CoderCallender/DSP_Projects/Basic_DSP_V0_1/Basic_DSP_V0_1.kicad_pcb

## KiCad design Basic_DSP_V0_1/Basic_DSP_V0_1.kicad_pcb (2024-11-25)

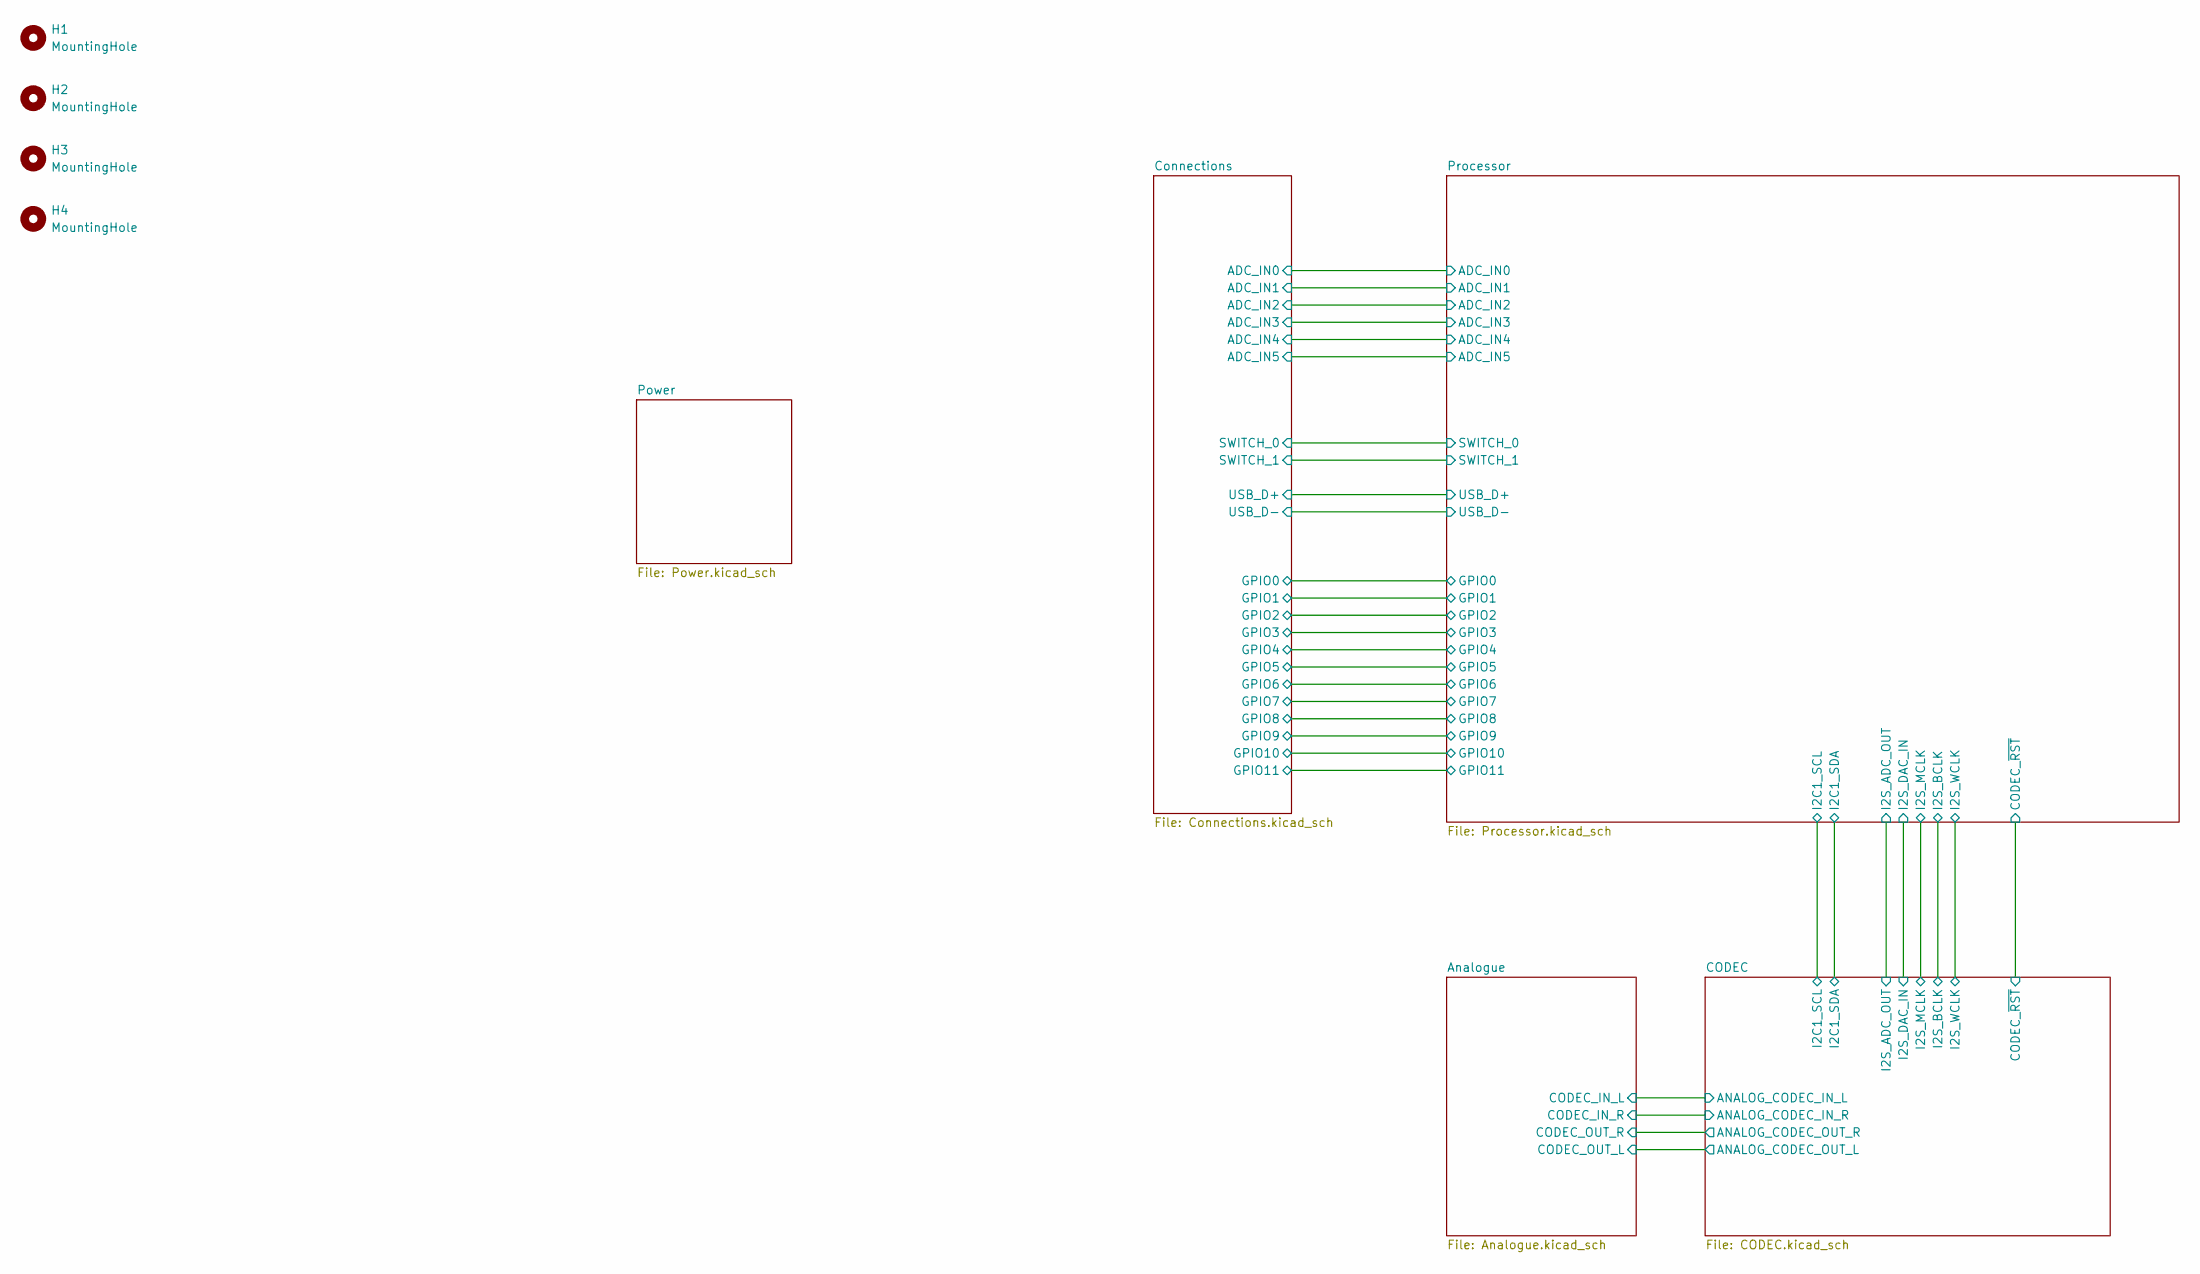
[picture p1: schematic Basic_DSP_V0_1.kicad_sch]

Parts:
H1, H2, H3, H4: MountingHole; MountingHole_3.2mm_M3_ISO7380_Pad

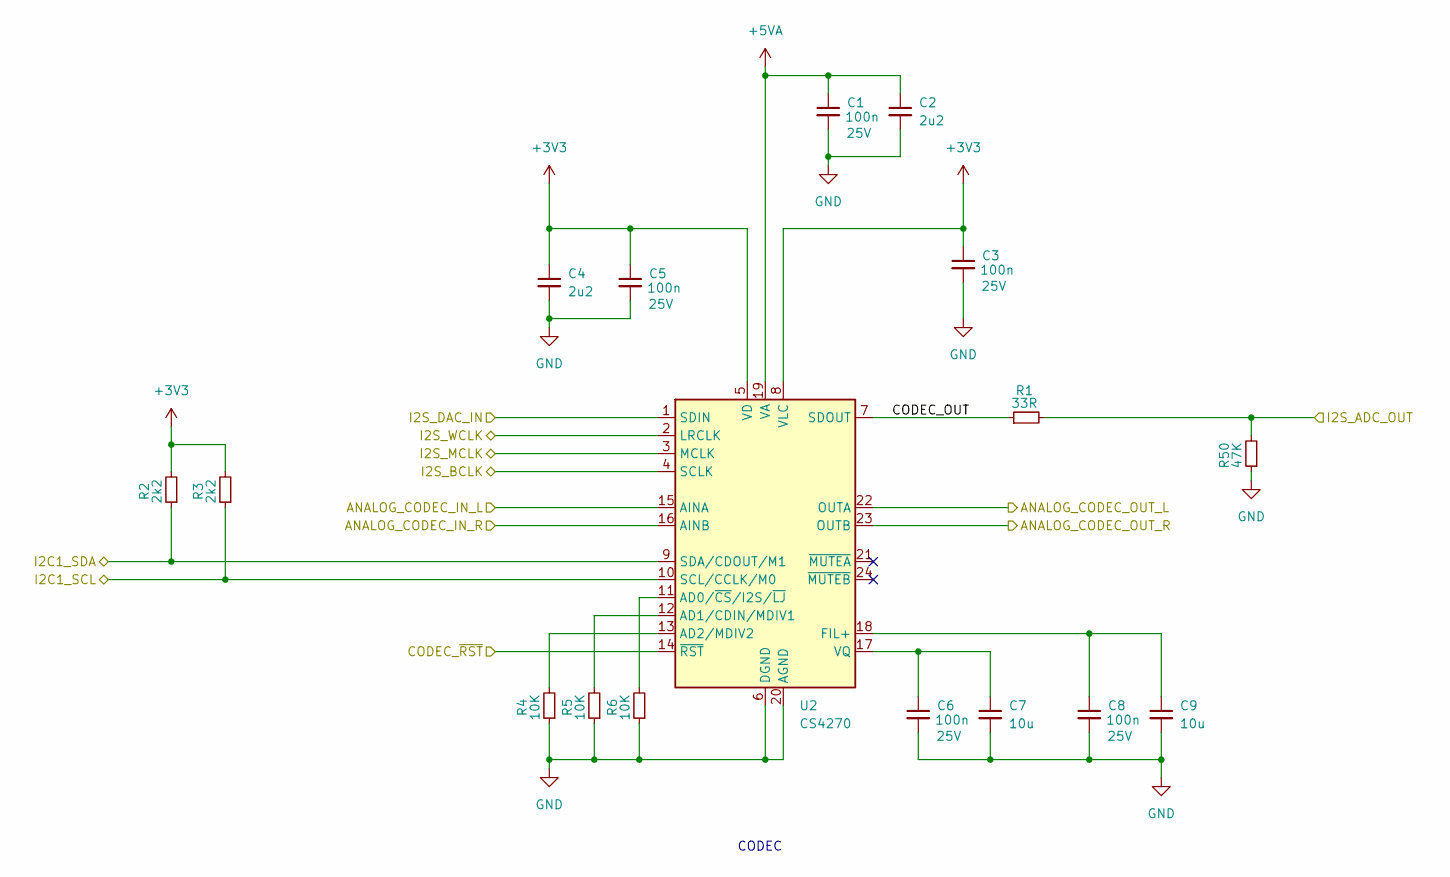
[picture p2: schematic CODEC.kicad_sch]

Parts:
C1, C3, C5, C6, C8: 100n; C_0603_1608Metric_Pad1.08x0.95mm_HandSolder; Voltage 25V; MPN 0603B104M250NT
C2, C4: 2u2; C_0603_1608Metric_Pad1.08x0.95mm_HandSolder; Voltage 25V; MPN 0603B225K250NT
C7, C9: 10u; C_0603_1608Metric_Pad1.08x0.95mm_HandSolder; Voltage 25V; MPN CL10A106MA8NRNC
R1: 33R; R_0603_1608Metric_Pad0.98x0.95mm_HandSolder; MPN WR06X33R0FTL
R2, R3: 2k2; R_0603_1608Metric_Pad0.98x0.95mm_HandSolder; MPN 0603WAF2201T5E
R4, R5, R6: 10K; R_0603_1608Metric_Pad0.98x0.95mm_HandSolder; MPN 0603WAF1002T5E
R50: 47K; R_0603_1608Metric_Pad0.98x0.95mm_HandSolder; MPN RC0603FR-0747KL
U2: CS4270; TSSOP-24_4.4x7.8mm_P0.65mm; MPN CS4270-CZZR

Connections:
+3V3: C3.1, C4.1, C5.1, R2.2, R3.2, U2.5 (VD), U2.8 (VLC); also elsewhere on the board
+5VA: C1.1, C2.1, U2.19 (VA); also elsewhere on the board
/Analogue/CODEC_IN_L: U2.15 (AINA); also elsewhere on the board
/Analogue/CODEC_IN_R: U2.16 (AINB); also elsewhere on the board
/Analogue/CODEC_OUT_L: U2.22 (OUTA); also elsewhere on the board
/Analogue/CODEC_OUT_R: U2.23 (OUTB); also elsewhere on the board
/CODEC/CODEC_OUT: R1.1, U2.7 (SDOUT)
/CODEC/CODEC_~RST: U2.14 (~RST); also elsewhere on the board
/CODEC/I2C1_SCL: R3.1, U2.10 (SCL/CCLK/M0); also elsewhere on the board
/CODEC/I2C1_SDA: R2.1, U2.9 (SDA/CDOUT/M1); also elsewhere on the board
/CODEC/I2S_ADC_OUT: R1.2, R50.2; also elsewhere on the board
/CODEC/I2S_BCLK: U2.4 (SCLK); also elsewhere on the board
/CODEC/I2S_DAC_IN: U2.1 (SDIN); also elsewhere on the board
/CODEC/I2S_MCLK: U2.3 (MCLK); also elsewhere on the board
/CODEC/I2S_WCLK: U2.2 (LRCLK); also elsewhere on the board
GND: C1.2, C2.2, C3.2, C4.2, C5.2, C6.2, C7.2, C8.2, C9.2, R4.1, R5.1, R6.1, R50.1, U2.6 (DGND), U2.20 (AGND); also elsewhere on the board
unnamed: R6.2, U2.11 (AD0/~CS/I2S/~LJ)
unnamed: R5.2, U2.12 (AD1/CDIN/MDIV1)
unnamed: R4.2, U2.13 (AD2/MDIV2)
unnamed: C8.1, C9.1, U2.18 (FIL+)
unnamed: C6.1, C7.1, U2.17 (VQ)

Notes on the sheet:
CODEC

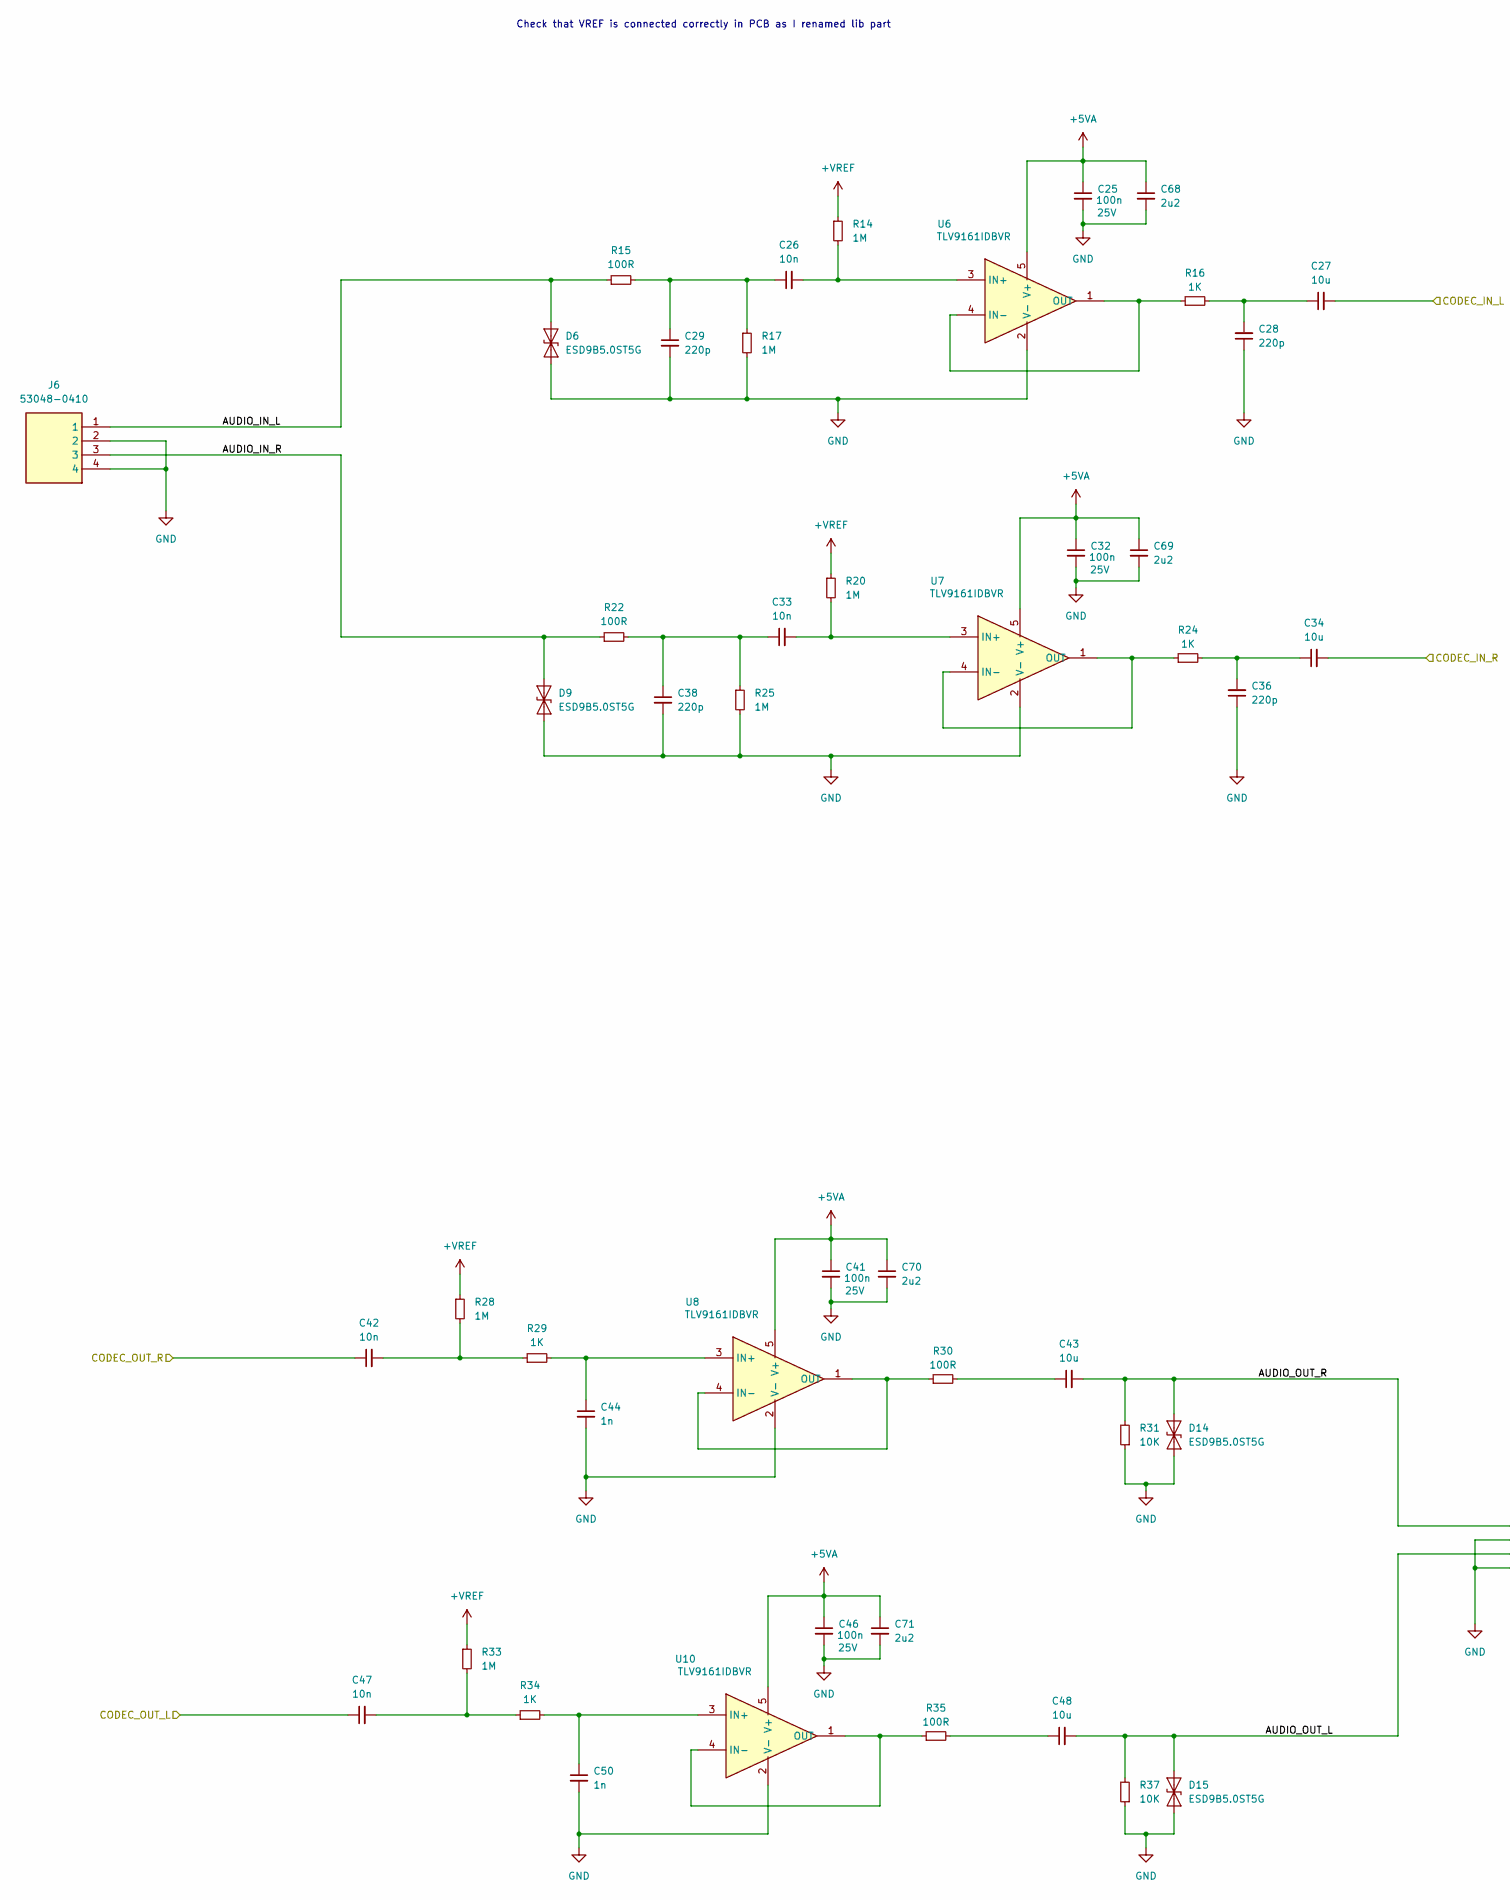
[picture p3: schematic Analogue.kicad_sch, part in row 1, column 1]

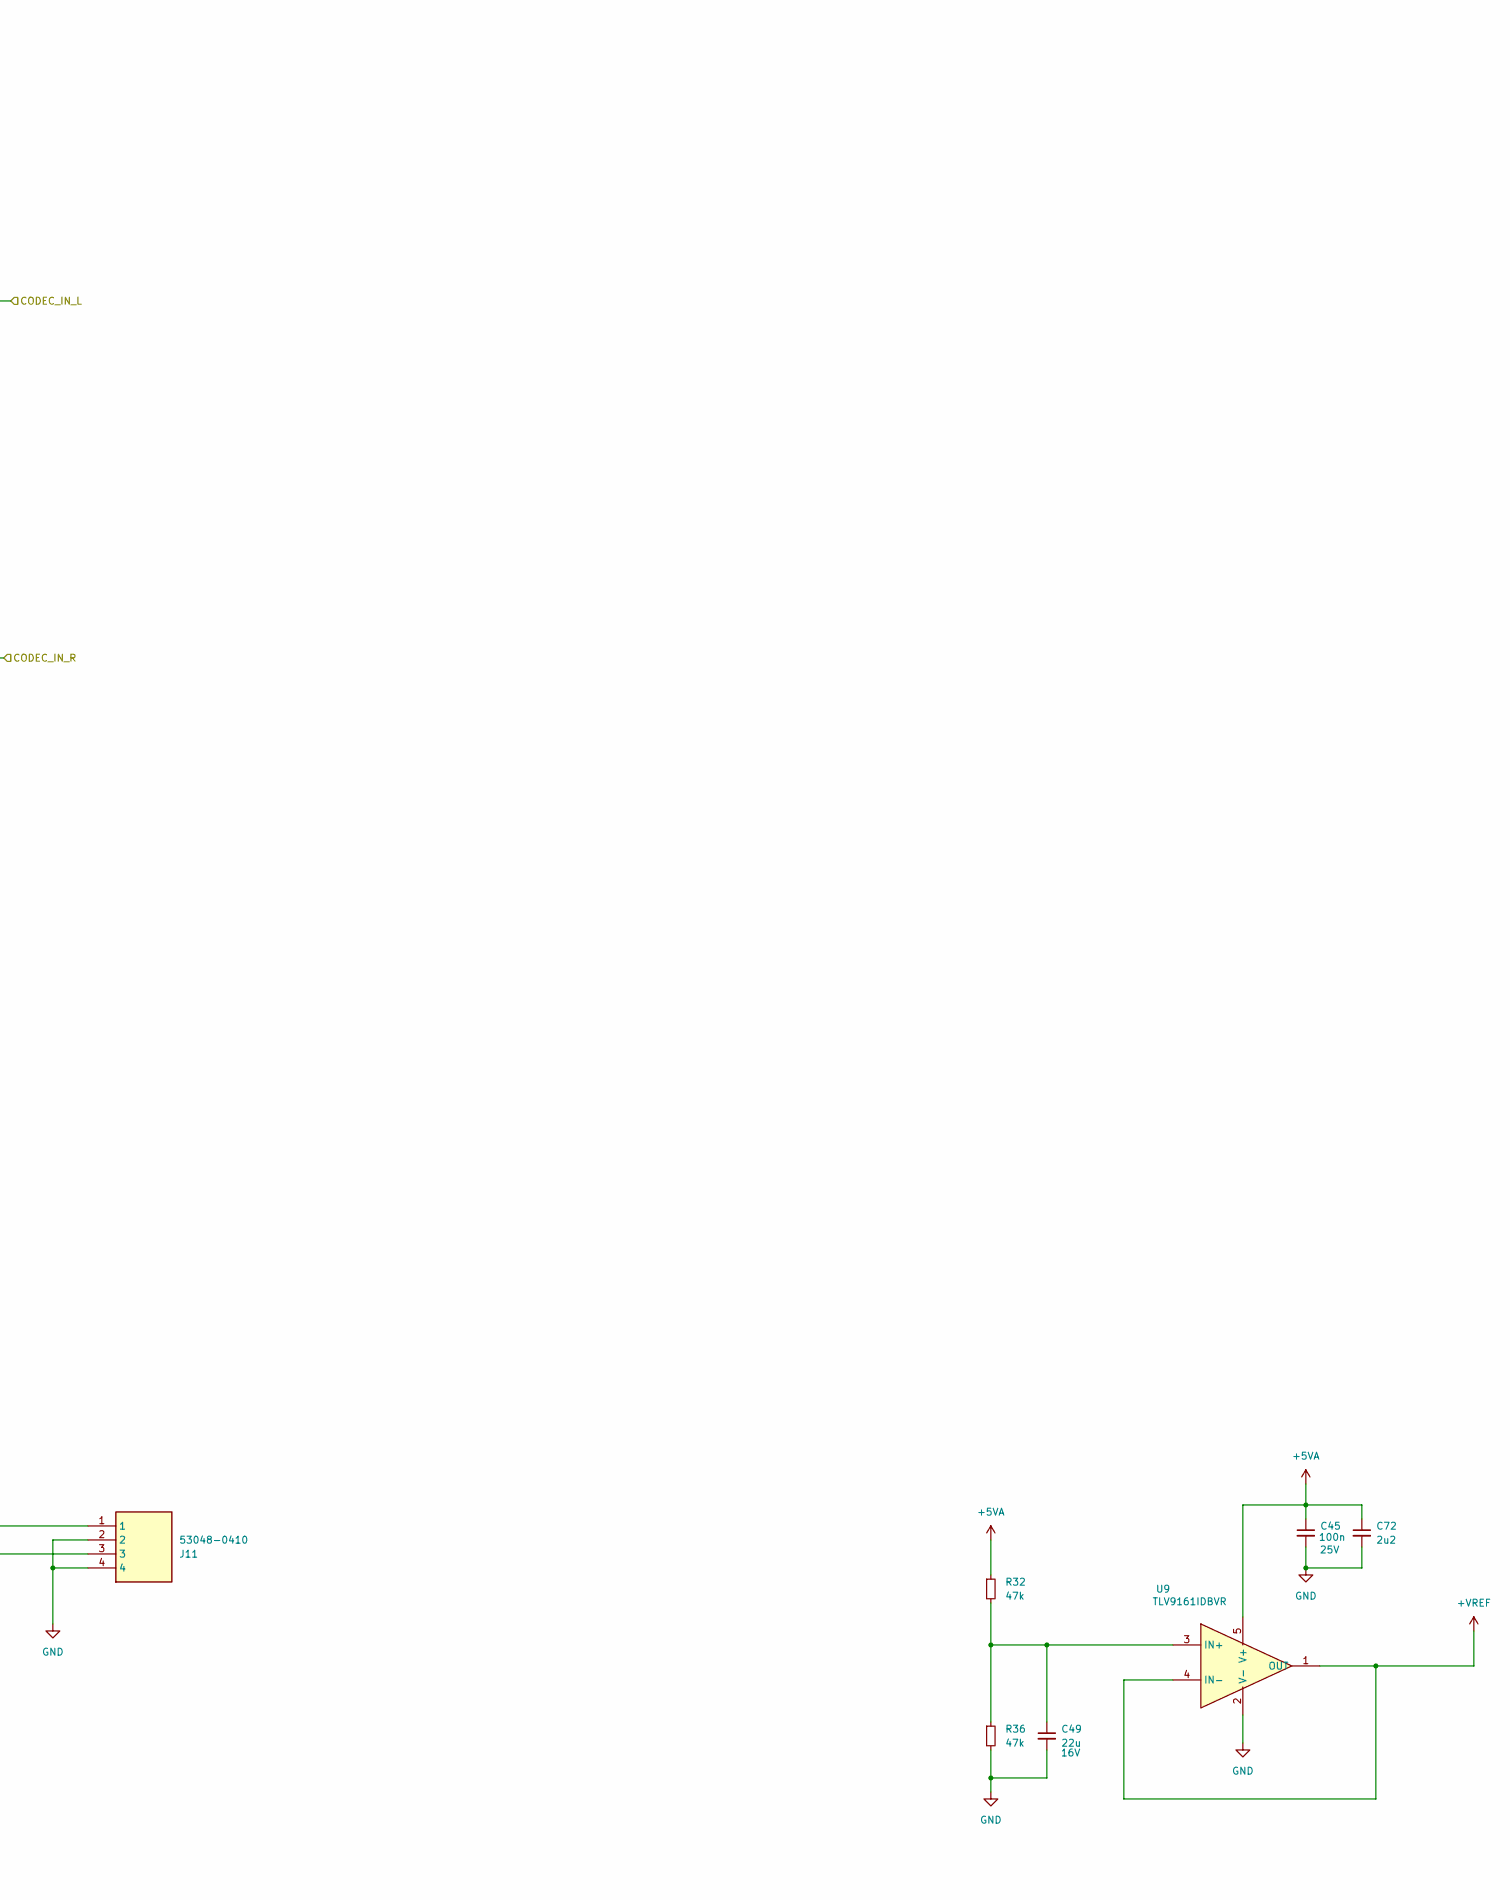
[picture p4: schematic Analogue.kicad_sch, part in row 1, column 2]

Parts:
C25, C32, C41, C45, C46: 100n; C_0603_1608Metric_Pad1.08x0.95mm_HandSolder; Voltage 25V; MPN 0603B104M250NT
C26, C33, C42, C47: 10n; C_0603_1608Metric_Pad1.08x0.95mm_HandSolder; MPN CGA3E2X8R2A103KT0Y0H
C27, C34, C43, C48: 10u; C_0603_1608Metric_Pad1.08x0.95mm_HandSolder; Voltage 16V; MPN CL10A106MA8NRNC
C28, C29, C36, C38: 220p; C_0603_1608Metric_Pad1.08x0.95mm_HandSolder; MPN 0603N221J500CT
C44, C50: 1n; C_0603_1608Metric_Pad1.08x0.95mm_HandSolder; MPN GCJ188R71H102KA01D
C49: 22u; C_0603_1608Metric_Pad1.08x0.95mm_HandSolder; Voltage 16V; MPN CGA0603X5R226M160JT
C68, C69, C70, C71, C72: 2u2; C_0603_1608Metric_Pad1.08x0.95mm_HandSolder; Voltage 25V; MPN 0603B225K250NT
D6, D9, D14, D15: ESD9B5.0ST5G; D_SOD-923; MPN ESD9B5.0ST5G
J6, J11: 53048-0410; 530480410; Mouser Part Number 538-53048-0410
R14, R17, R20, R25, R28, R33: 1M; R_0603_1608Metric_Pad0.98x0.95mm_HandSolder; MPN 0603WAF1004T5E
R15, R22, R30, R35: 100R; R_0603_1608Metric_Pad0.98x0.95mm_HandSolder; MPN RC0603FR-07100RL
R16, R24, R29, R34: 1K; R_0603_1608Metric_Pad0.98x0.95mm_HandSolder; MPN 0603WAJ0102T5E
R31, R37: 10K; R_0603_1608Metric_Pad0.98x0.95mm_HandSolder; MPN 0603WAF1002T5E
R32, R36: 47k; R_0603_1608Metric_Pad0.98x0.95mm_HandSolder; MPN RC0603FR-0747KL
U6, U7, U8, U9, U10: TLV9161IDBVR; SOT95P280X145-5N; Mouser Part Number 595-TLV9161IDBVR

Connections:
+5VA: C25.1, C32.1, C41.1, C45.1, C46.1, C68.1, C69.1, C70.1, C71.1, C72.1, R32.1, U6.5 (V+), U7.5 (V+), U8.5 (V+), U9.5 (V+), U10.5 (V+); also elsewhere on the board
+VREF: R14.1, R20.1, R28.1, R33.1, U9.1 (OUT), U9.4 (IN-)
/Analogue/AUDIO_IN_L: D6.2 (A2), J6.1, R15.1
/Analogue/AUDIO_IN_R: D9.2 (A2), J6.3, R22.1
/Analogue/AUDIO_OUT_L: C48.2, D15.2 (A2), J11.3, R37.2
/Analogue/AUDIO_OUT_R: C43.2, D14.2 (A2), J11.1, R31.2
/Analogue/CODEC_IN_L: C27.2; also elsewhere on the board
/Analogue/CODEC_IN_R: C34.2; also elsewhere on the board
/Analogue/CODEC_OUT_L: C47.1; also elsewhere on the board
/Analogue/CODEC_OUT_R: C42.1; also elsewhere on the board
GND: C25.2, C28.1, C29.2, C32.2, C36.1, C38.2, C41.2, C44.2, C45.2, C46.2, C49.2, C50.2, C68.2, C69.2, C70.2, C71.2, C72.2, D6.1 (A1), D9.1 (A1), D14.1 (A1), D15.1 (A1), J6.2, J6.4, J11.2, J11.4, R17.2, R25.2, R31.1, R36.2, R37.1, U6.2 (V-), U7.2 (V-), U8.2 (V-), U9.2 (V-), U10.2 (V-); also elsewhere on the board
unnamed: C26.1, C29.1, R15.2, R17.1
unnamed: C27.1, C28.2, R16.2
unnamed: C33.1, C38.1, R22.2, R25.1
unnamed: C34.1, C36.2, R24.2
unnamed: C42.2, R28.2, R29.1
unnamed: C43.1, R30.2
unnamed: C47.2, R33.2, R34.1
unnamed: C48.1, R35.2
unnamed: C26.2, R14.2, U6.3 (IN+)
unnamed: R16.1, U6.1 (OUT), U6.4 (IN-)
unnamed: C33.2, R20.2, U7.3 (IN+)
unnamed: R24.1, U7.1 (OUT), U7.4 (IN-)
unnamed: C44.1, R29.2, U8.3 (IN+)
unnamed: R30.1, U8.1 (OUT), U8.4 (IN-)
unnamed: C49.1, R32.2, R36.1, U9.3 (IN+)
unnamed: C50.1, R34.2, U10.3 (IN+)
unnamed: R35.1, U10.1 (OUT), U10.4 (IN-)

Notes on the sheet:
Check that VREF is connected correctly in PCB as I renamed lib part

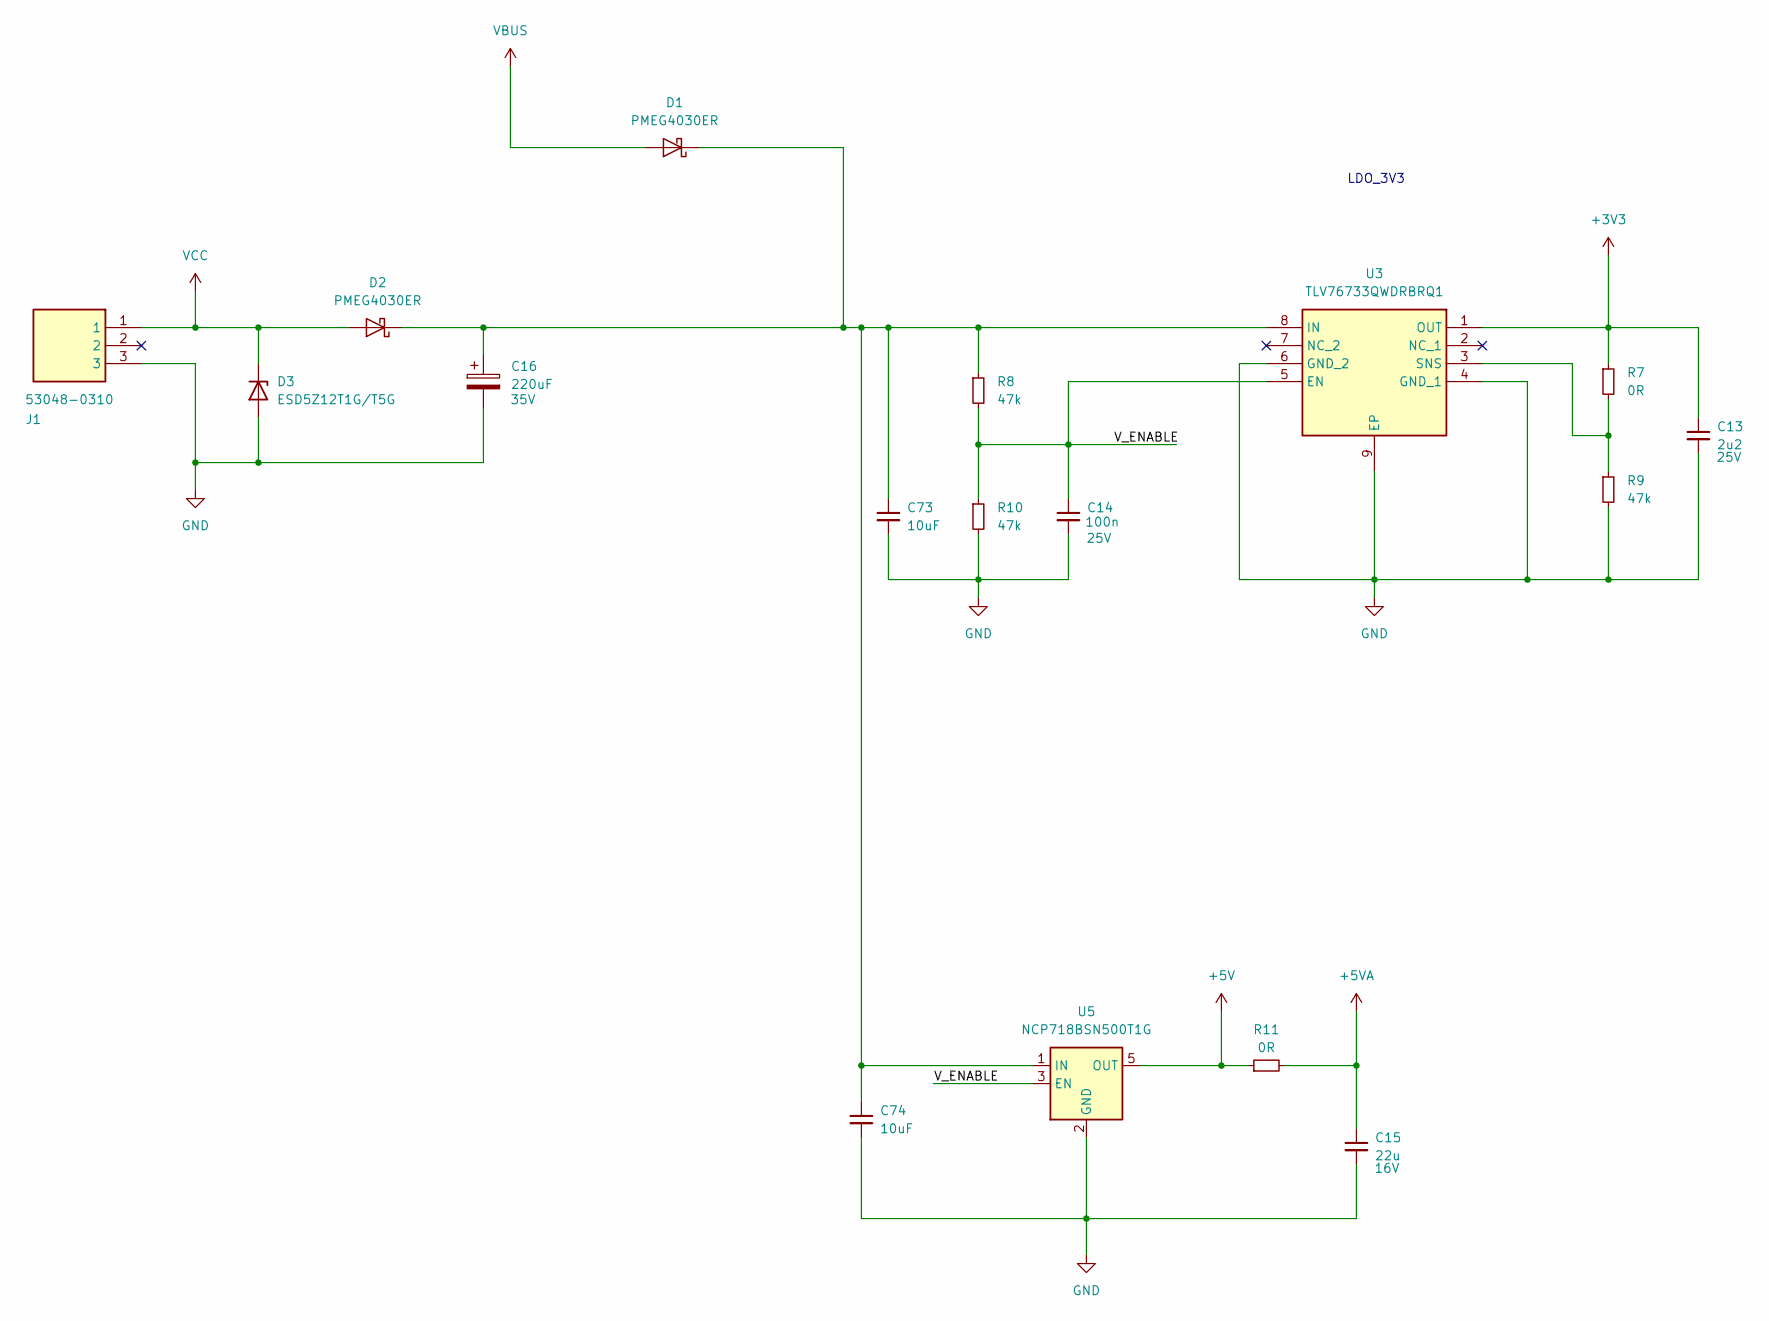
[picture p5: schematic Power.kicad_sch]

Parts:
C13: 2u2; C_0603_1608Metric_Pad1.08x0.95mm_HandSolder; Voltage 25V; MPN 0603B225K250NT
C14: 100n; C_0603_1608Metric_Pad1.08x0.95mm_HandSolder; Voltage 25V; MPN 0603B104M250NT
C15: 22u; C_0603_1608Metric_Pad1.08x0.95mm_HandSolder; Voltage 16V; MPN CGA0603X5R226M160JT
C16: 220uF; CP_Elec_8x10.5; Voltage 35V; MPN CK1V221M-CRF10
C73, C74: 10uF; C_0603_1608Metric; MPN CL10A106MA8NRNC
D1, D2: PMEG4030ER; Nexperia_CFP3_SOD-123W; MPN PMEG4030ER
D3: ESD5Z12T1G/T5G; D_SOD-523; Voltage 12V; MPN ESD5Z12T1G
J1: 53048-0310; SHDRRA3W35P0X125_1X3_550X550X350P; Mouser Part Number 538-53048-0310
R7: 0R; R_0603_1608Metric_Pad0.98x0.95mm_HandSolder; MPN 0603WAF0000T5E
R8, R9, R10: 47k; R_0603_1608Metric_Pad0.98x0.95mm_HandSolder; MPN RC0603FR-0747KL
R11: 0R; R_0603_1608Metric_Pad0.98x0.95mm_HandSolder; MPN 0603WAF100JT5E
U3: TLV76733QWDRBRQ1; SON65P300X300X100-9N-D; Mouser Part Number 595-TLV76733QWDRBRQ1
U5: NCP718BSN500T1G; SOT-23-5; MPN NCP718BSN500T1G

Connections:
+3V3: C13.1, R7.1, U3.1 (OUT); also elsewhere on the board
+5V: R11.1, U5.5 (OUT); also elsewhere on the board
+5VA: C15.1, R11.2; also elsewhere on the board
/Power/V_ENABLE: C14.1, R8.2, R10.1, U3.5 (EN), U5.3 (EN)
GND: C13.2, C14.2, C15.2, C16.2, C73.2, C74.2, D3.2 (A), J1.3, R9.2, R10.2, U3.4 (GND_1), U3.6 (GND_2), U3.9 (EP), U5.2 (GND); also elsewhere on the board
unnamed: C16.1, C73.1, C74.1, D1.1 (K), D2.1 (K), R8.1, U3.8 (IN), U5.1 (IN)
unnamed: R7.2, R9.1, U3.3 (SNS)
VBUS: D1.2 (A); also elsewhere on the board
VCC: D2.2 (A), D3.1 (K), J1.1

Notes on the sheet:
LDO_3V3

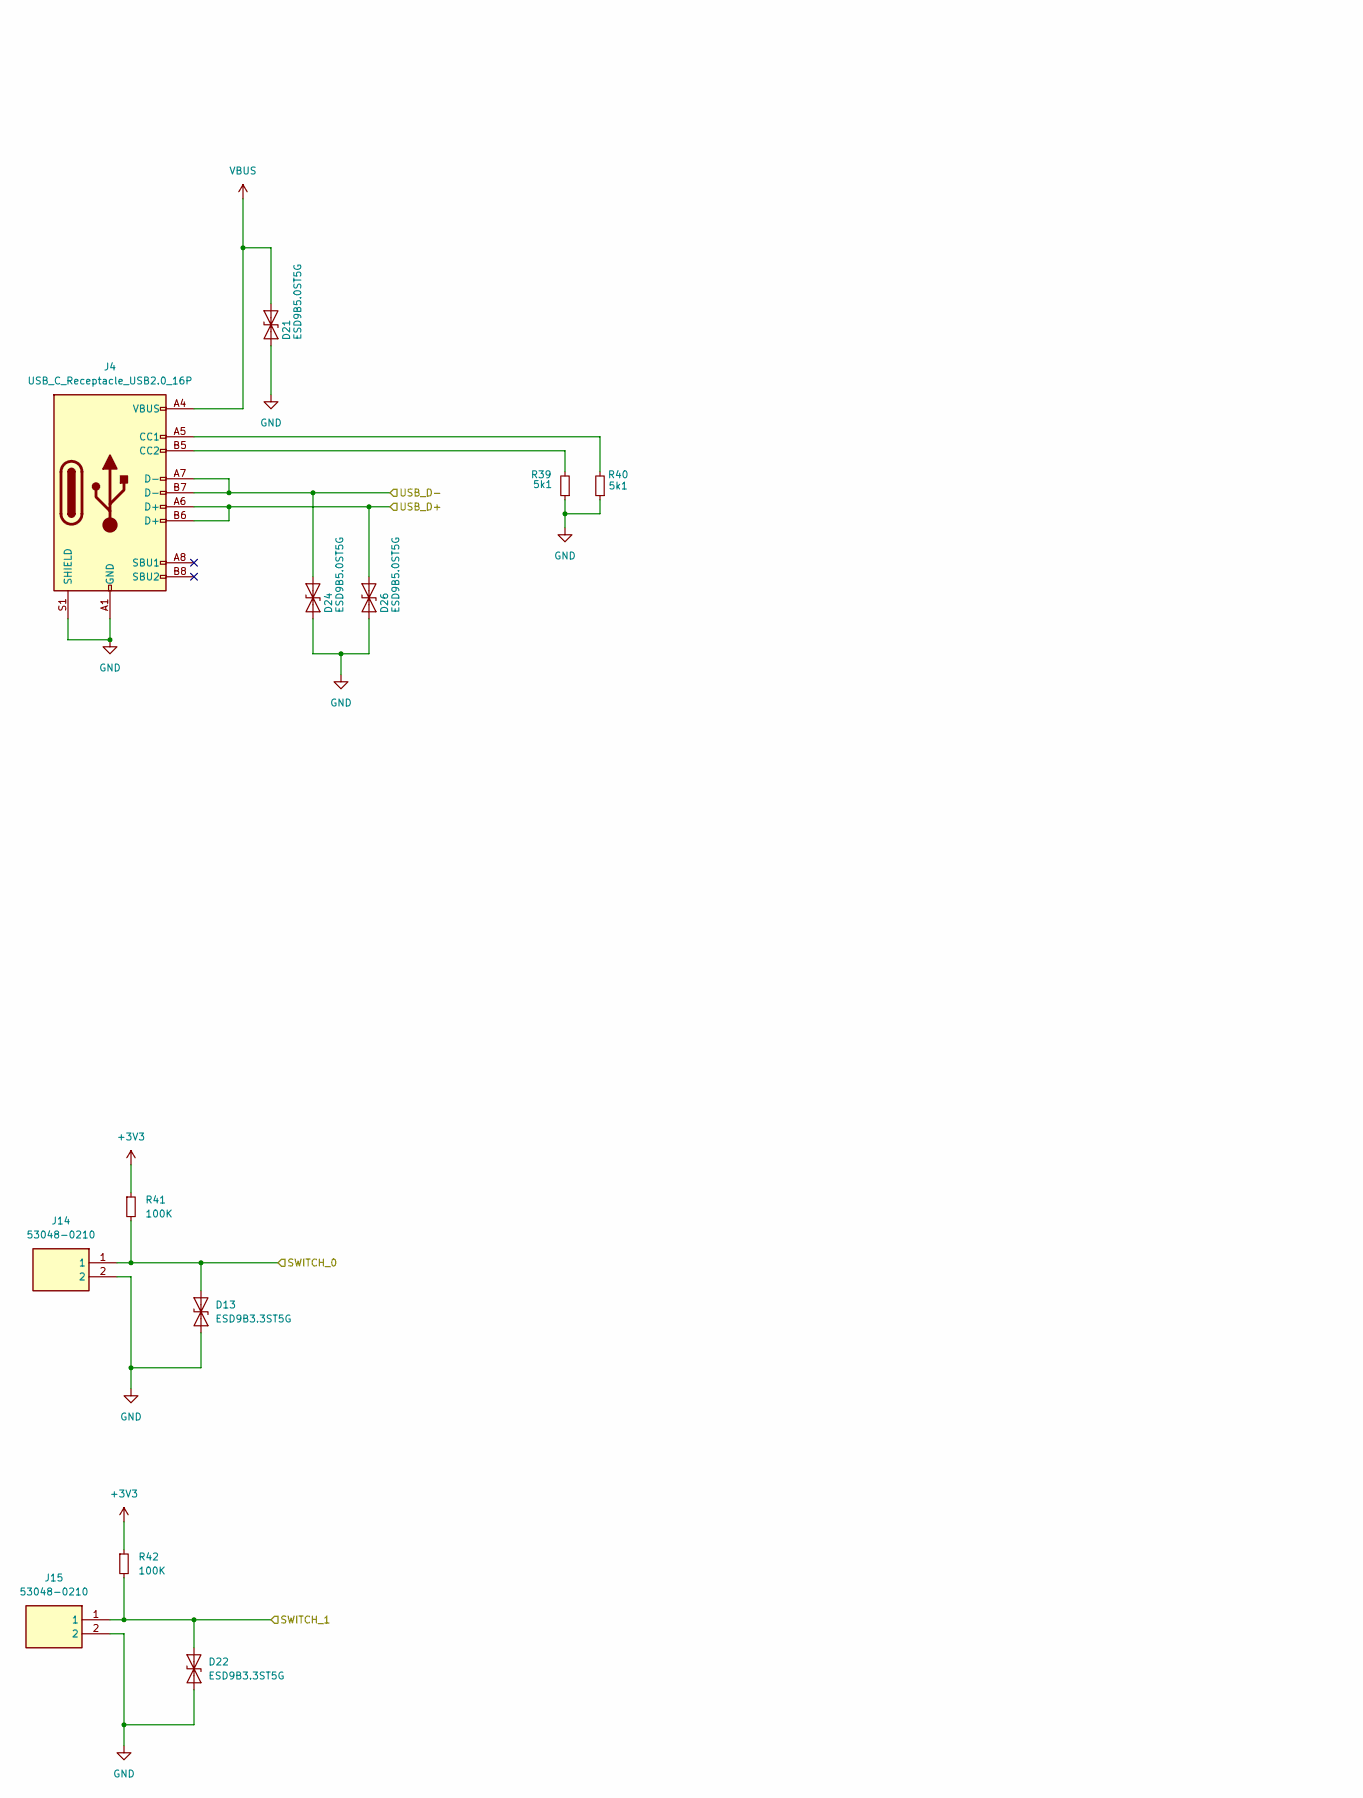
[picture p6: schematic Connections.kicad_sch, part in row 1, column 1]

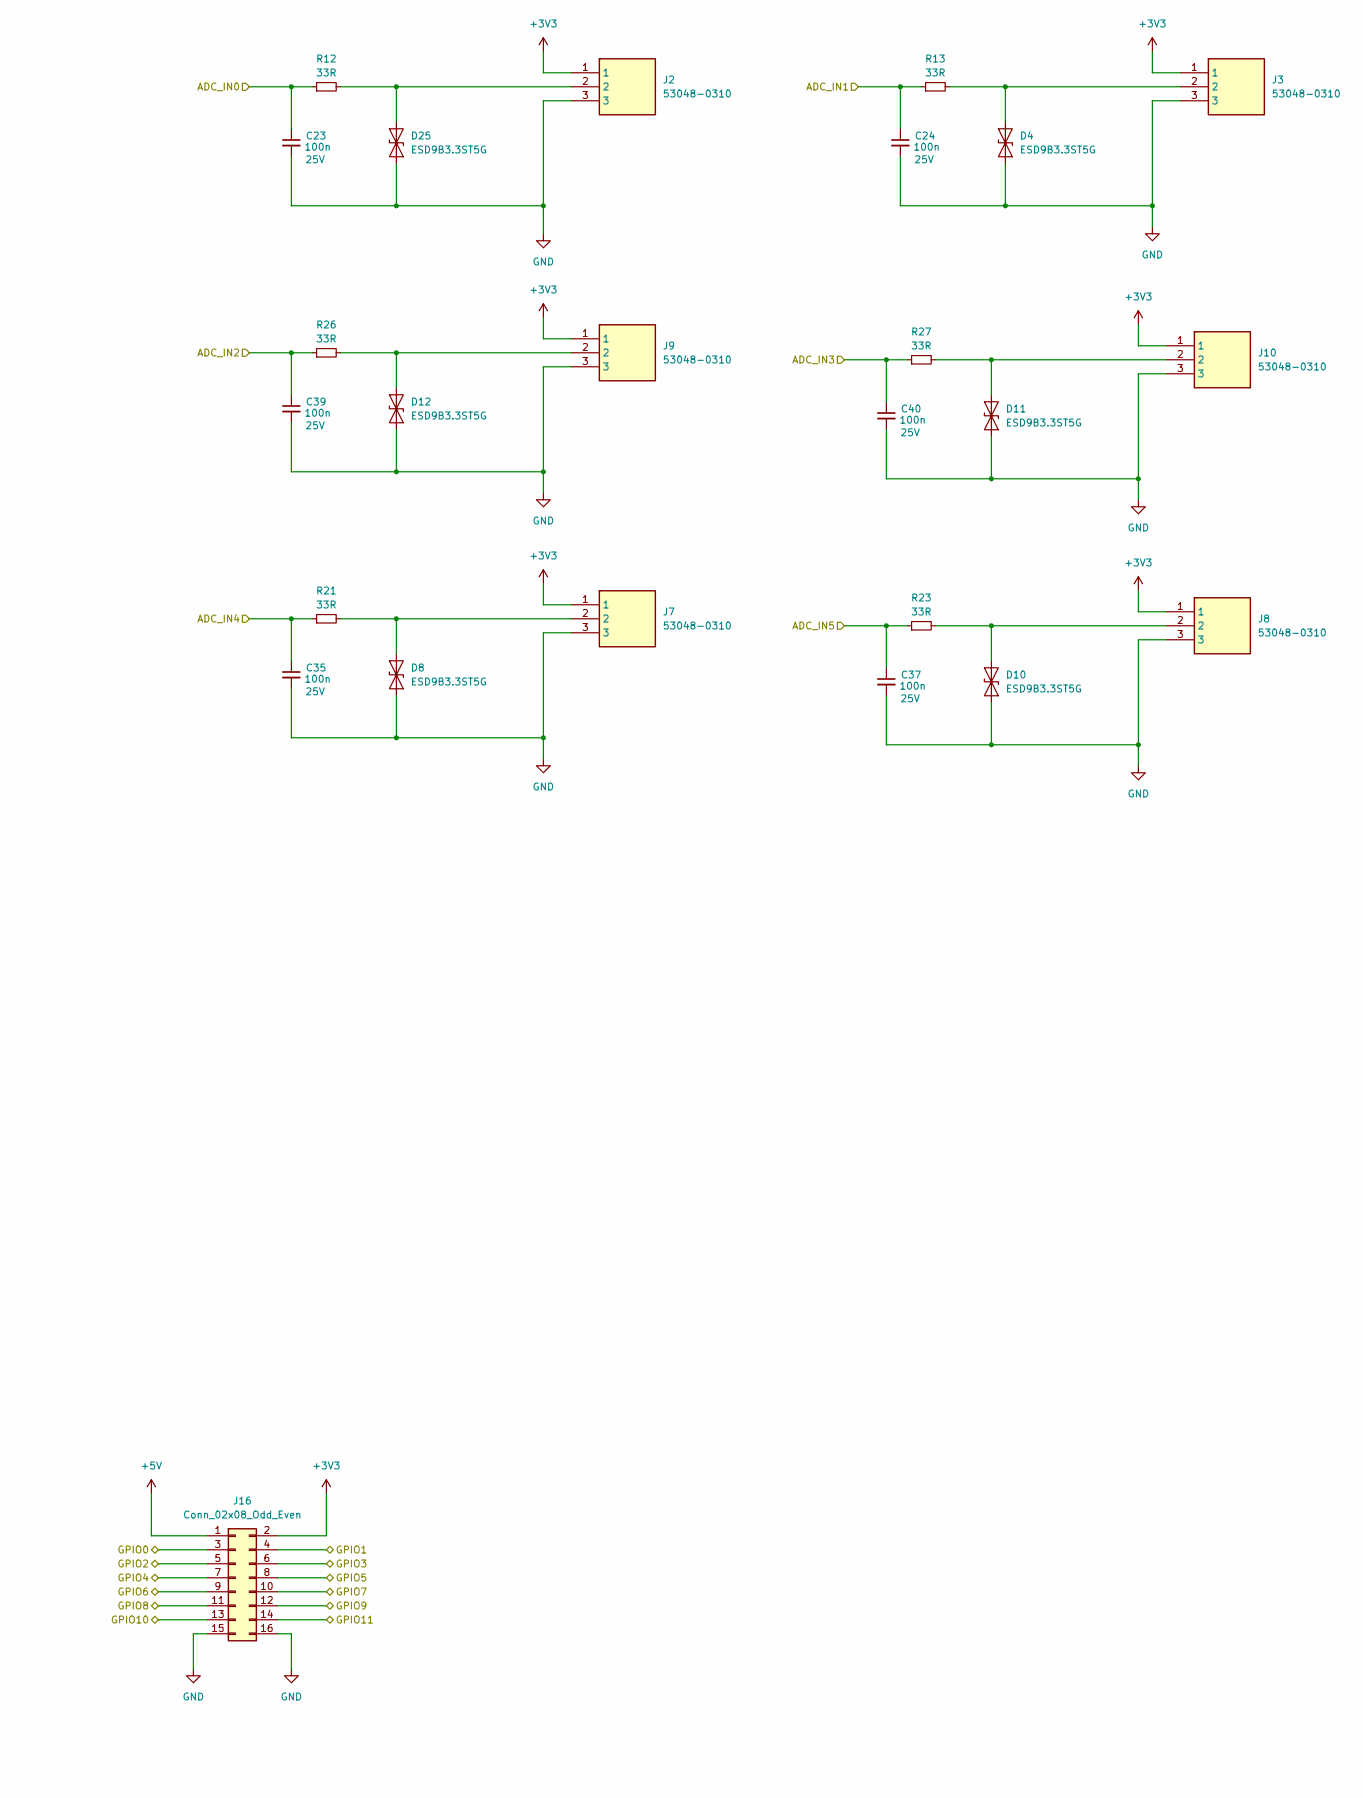
[picture p7: schematic Connections.kicad_sch, part in row 1, column 2]

Parts:
C23, C24, C35, C37, C39, C40: 100n; C_0603_1608Metric_Pad1.08x0.95mm_HandSolder; Voltage 25V; MPN 0603B104M250NT
D4, D8, D10, D11, D12, D13, D22, D25: ESD9B3.3ST5G; D_SOD-923; MPN ESD9B3.3ST5G
D21, D24, D26: ESD9B5.0ST5G; D_SOD-923; MPN ESD9B5.0ST5G
J2, J3, J7, J8, J9, J10: 53048-0310; SHDRRA3W35P0X125_1X3_550X550X350P; Mouser Part Number 538-53048-0310
J4: USB_C_Receptacle_USB2.0_16P; USB_C_Receptacle_GCT_USB4110
J14, J15: 53048-0210; SHDRRA2W35P0X125_1X2_425X550X350P; Mouser Part Number 538-53048-0210
J16: Conn_02x08_Odd_Even; PinSocket_2x08_P2.54mm_Vertical
R12, R13, R21, R23, R26, R27: 33R; R_0603_1608Metric_Pad0.98x0.95mm_HandSolder; MPN WR06X33R0FTL
R39, R40: 5k1; R_0603_1608Metric_Pad0.98x0.95mm_HandSolder; MPN 0603WAF5101T5E
R41, R42: 100K; R_0603_1608Metric_Pad0.98x0.95mm_HandSolder; MPN RC0603FR-07100KL

Connections:
+3V3: J2.1, J3.1, J7.1, J8.1, J9.1, J10.1, J16.2, R41.1, R42.1; also elsewhere on the board
+5V: J16.1; also elsewhere on the board
/Connections/ADC_IN0: C23.1, R12.1; also elsewhere on the board
/Connections/ADC_IN1: C24.1, R13.1; also elsewhere on the board
/Connections/ADC_IN2: C39.1, R26.1; also elsewhere on the board
/Connections/ADC_IN3: C40.1, R27.1; also elsewhere on the board
/Connections/ADC_IN4: C35.1, R21.1; also elsewhere on the board
/Connections/ADC_IN5: C37.1, R23.1; also elsewhere on the board
/Connections/GPIO0: J16.3; also elsewhere on the board
/Connections/GPIO1: J16.4; also elsewhere on the board
/Connections/GPIO2: J16.5; also elsewhere on the board
/Connections/GPIO3: J16.6; also elsewhere on the board
/Connections/GPIO4: J16.7; also elsewhere on the board
/Connections/GPIO5: J16.8; also elsewhere on the board
/Connections/GPIO6: J16.9; also elsewhere on the board
/Connections/GPIO7: J16.10; also elsewhere on the board
/Connections/GPIO8: J16.11; also elsewhere on the board
/Connections/GPIO9: J16.12; also elsewhere on the board
/Connections/GPIO10: J16.13; also elsewhere on the board
/Connections/GPIO11: J16.14; also elsewhere on the board
/Connections/SWITCH_0: D13.2 (A2), J14.1, R41.2; also elsewhere on the board
/Connections/SWITCH_1: D22.2 (A2), J15.1, R42.2; also elsewhere on the board
/Connections/USB_D+: D26.2 (A2), J4.A6 (D+), J4.B6 (D+); also elsewhere on the board
/Connections/USB_D-: D24.2 (A2), J4.A7 (D-), J4.B7 (D-); also elsewhere on the board
GND: C23.2, C24.2, C35.2, C37.2, C39.2, C40.2, D4.1 (A1), D8.1 (A1), D10.1 (A1), D11.1 (A1), D12.1 (A1), D13.1 (A1), D21.1 (A1), D22.1 (A1), D24.1 (A1), D25.1 (A1), D26.1 (A1), J2.3, J3.3, J4.A1 (GND), J4.A12 (GND), J4.B1 (GND), J4.B12 (GND), J4.S1 (SHIELD), J7.3, J8.3, J9.3, J10.3, J14.2, J15.2, J16.15, J16.16, R39.1, R40.1; also elsewhere on the board
unnamed: D4.2 (A2), J3.2, R13.2
unnamed: D8.2 (A2), J7.2, R21.2
unnamed: D10.2 (A2), J8.2, R23.2
unnamed: D11.2 (A2), J10.2, R27.2
unnamed: D12.2 (A2), J9.2, R26.2
unnamed: D25.2 (A2), J2.2, R12.2
unnamed: J4.A5 (CC1), R40.2
unnamed: J4.B5 (CC2), R39.2
VBUS: D21.2 (A2), J4.A4 (VBUS), J4.A9 (VBUS), J4.B4 (VBUS), J4.B9 (VBUS); also elsewhere on the board
