CoderCallender/DSP_Projects/Basic_DSP_V0_1/Basic_DSP_V0_1.kicad_pcb

## KiCad design Basic_DSP_V0_1/Basic_DSP_V0_1.kicad_pcb (continued)

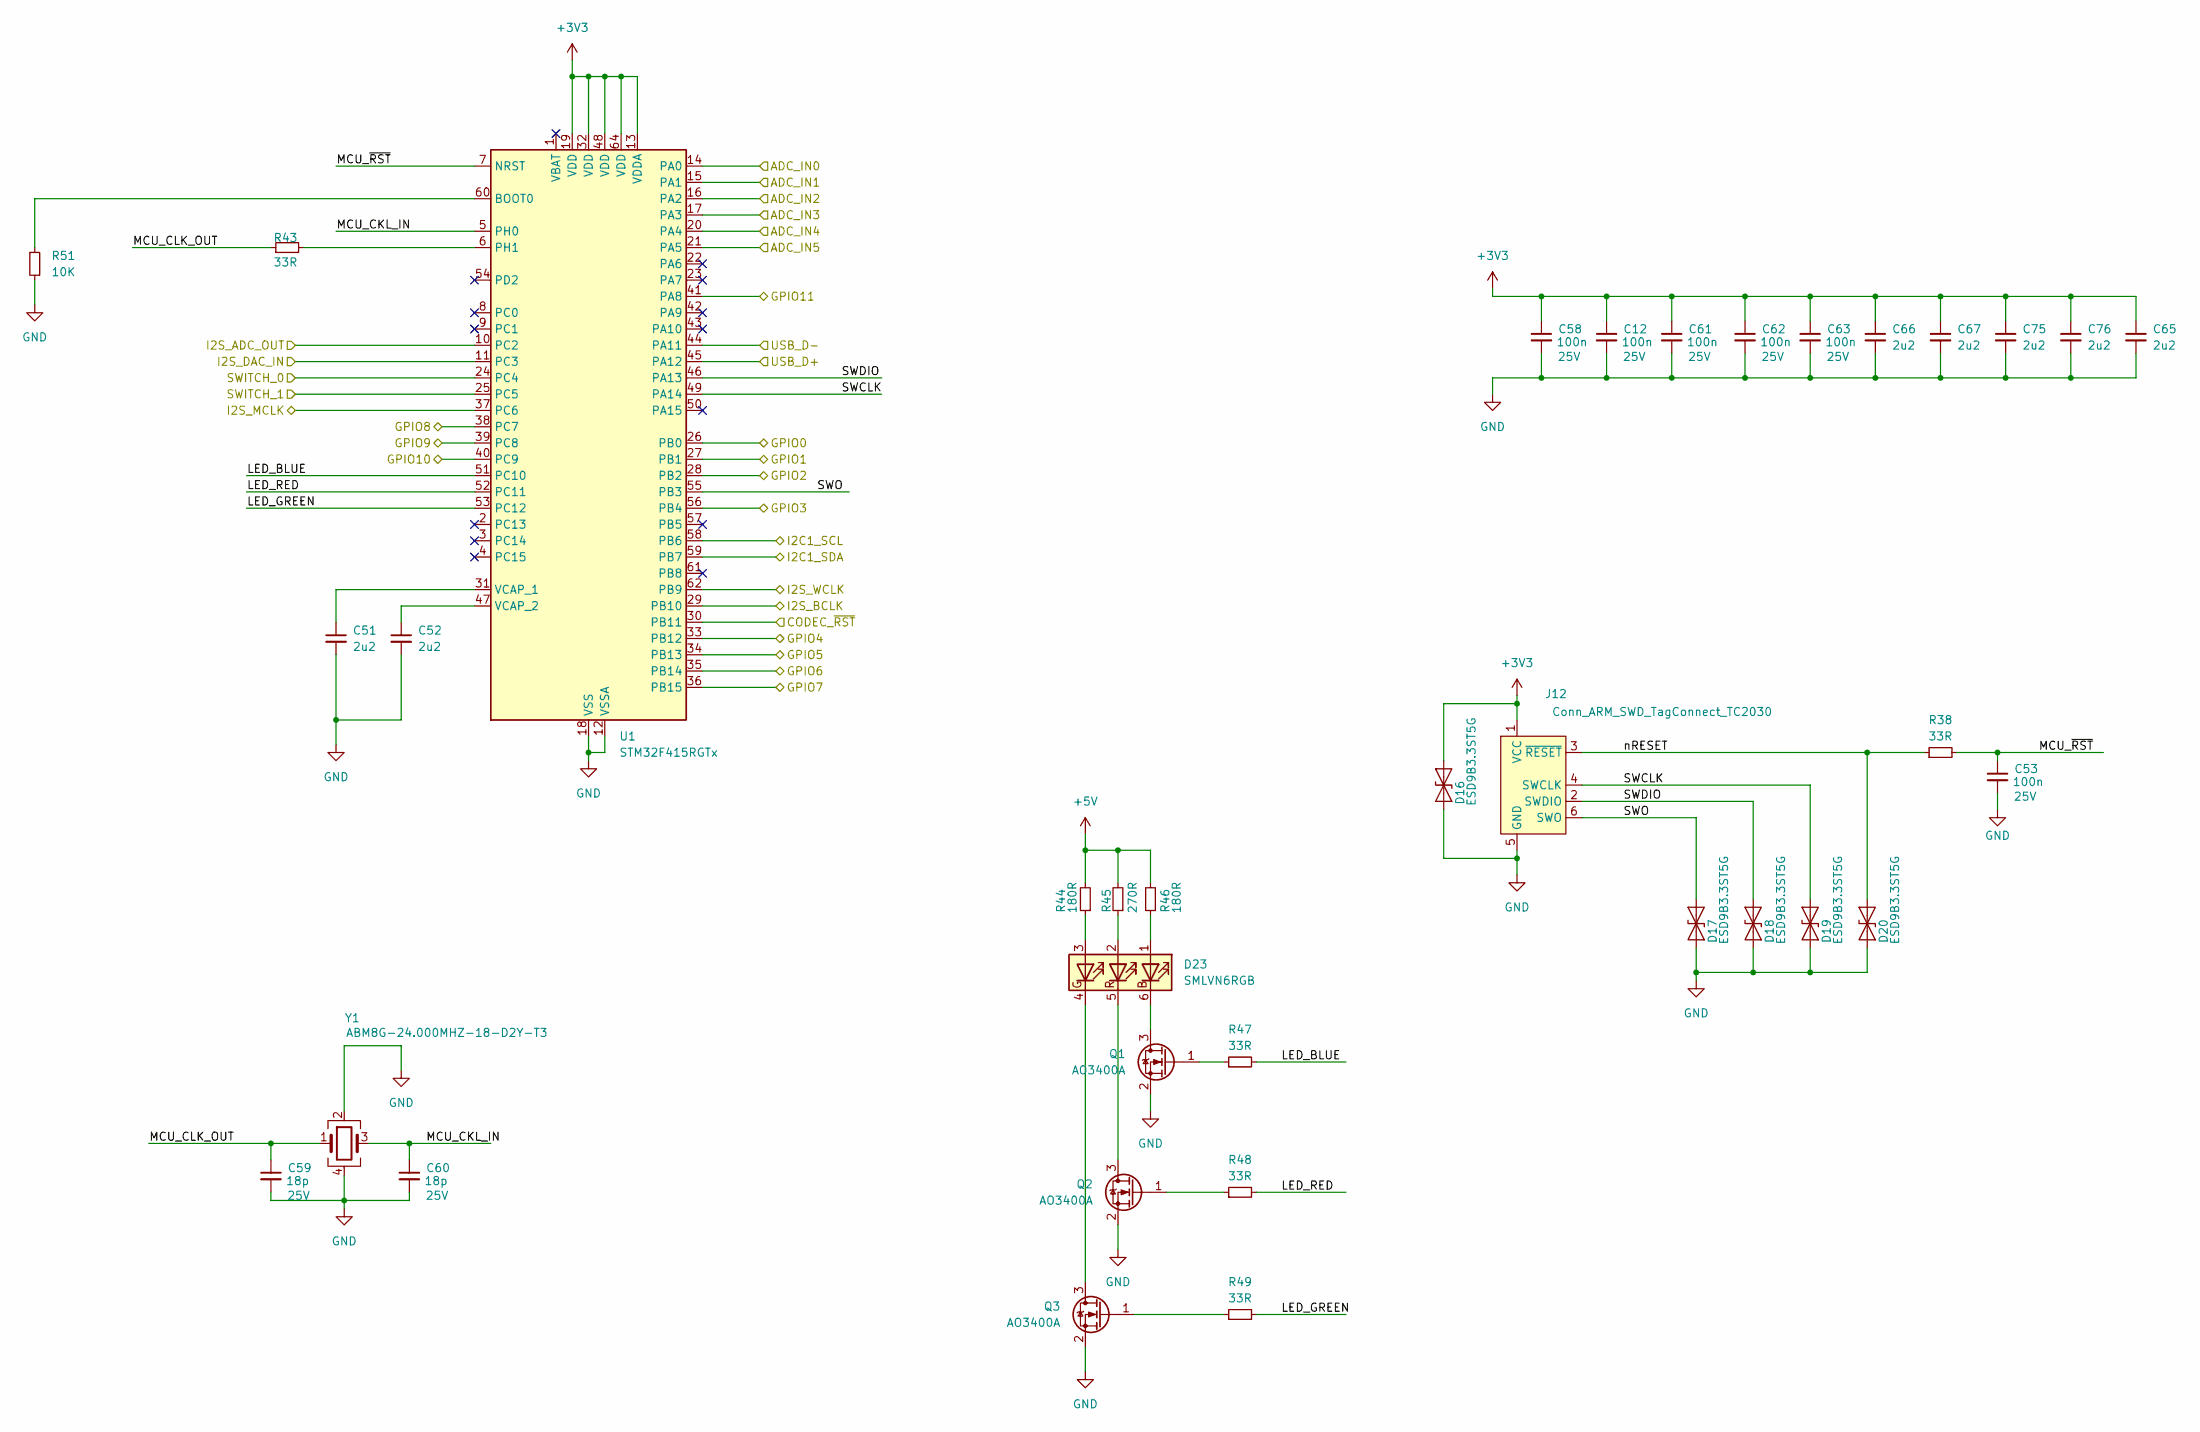
[picture p8: schematic Processor.kicad_sch]

Parts:
C12, C53, C58, C61, C62, C63: 100n; C_0603_1608Metric_Pad1.08x0.95mm_HandSolder; Voltage 25V; MPN 0603B104M250NT
C51, C52, C65, C66, C67, C75, C76: 2u2; C_0603_1608Metric_Pad1.08x0.95mm_HandSolder; Voltage 25V; MPN 0603B225K250NT
C59, C60: 18p; C_0603_1608Metric_Pad1.08x0.95mm_HandSolder; Voltage 25V; MPN RF18N180F500CT
D16, D17, D18, D19, D20: ESD9B3.3ST5G; D_SOD-923; MPN ESD9B3.3ST5G
D23: SMLVN6RGB; LED_ROHM_SMLVN6; MPN SMLVN6RGB1W1
J12: Conn_ARM_SWD_TagConnect_TC2030; Tag-Connect_TC2030-IDC-FP_2x03_P1.27mm_Vertical
Q1, Q2, Q3: AO3400A; SOT-23; MPN AO3400A
R38, R43, R47, R48, R49: 33R; R_0603_1608Metric_Pad0.98x0.95mm_HandSolder; MPN WR06X33R0FTL
R44, R46: 180R; R_0603_1608Metric_Pad0.98x0.95mm_HandSolder; MPN 0603WAF1800T5E
R45: 270R; R_0603_1608Metric_Pad0.98x0.95mm_HandSolder; MPN 0603WAF2700T5E
R51: 10K; R_0603_1608Metric_Pad0.98x0.95mm_HandSolder; MPN 0603WAF1002T5E
U1: STM32F415RGTx; LQFP-64_10x10mm_P0.5mm; MPN STM32F415RGT6
Y1: ABM8G-24.000MHZ-18-D2Y-T3; Crystal_SMD_Abracon_ABM8G-4Pin_3.2x2.5mm

Connections:
+3V3: C12.1, C58.1, C61.1, C62.1, C63.1, C65.1, C66.1, C67.1, C75.1, C76.1, D16.2 (A2), J12.1 (VCC), U1.13 (VDDA), U1.19 (VDD), U1.32 (VDD), U1.48 (VDD), U1.64 (VDD); also elsewhere on the board
+5V: R44.2, R45.2, R46.2; also elsewhere on the board
/CODEC/CODEC_~RST: U1.30 (PB11); also elsewhere on the board
/CODEC/I2C1_SCL: U1.58 (PB6); also elsewhere on the board
/CODEC/I2C1_SDA: U1.59 (PB7); also elsewhere on the board
/CODEC/I2S_ADC_OUT: U1.10 (PC2); also elsewhere on the board
/CODEC/I2S_BCLK: U1.29 (PB10); also elsewhere on the board
/CODEC/I2S_DAC_IN: U1.11 (PC3); also elsewhere on the board
/CODEC/I2S_MCLK: U1.37 (PC6); also elsewhere on the board
/CODEC/I2S_WCLK: U1.62 (PB9); also elsewhere on the board
/Connections/ADC_IN0: U1.14 (PA0); also elsewhere on the board
/Connections/ADC_IN1: U1.15 (PA1); also elsewhere on the board
/Connections/ADC_IN2: U1.16 (PA2); also elsewhere on the board
/Connections/ADC_IN3: U1.17 (PA3); also elsewhere on the board
/Connections/ADC_IN4: U1.20 (PA4); also elsewhere on the board
/Connections/ADC_IN5: U1.21 (PA5); also elsewhere on the board
/Connections/GPIO0: U1.26 (PB0); also elsewhere on the board
/Connections/GPIO1: U1.27 (PB1); also elsewhere on the board
/Connections/GPIO2: U1.28 (PB2); also elsewhere on the board
/Connections/GPIO3: U1.56 (PB4); also elsewhere on the board
/Connections/GPIO4: U1.33 (PB12); also elsewhere on the board
/Connections/GPIO5: U1.34 (PB13); also elsewhere on the board
/Connections/GPIO6: U1.35 (PB14); also elsewhere on the board
/Connections/GPIO7: U1.36 (PB15); also elsewhere on the board
/Connections/GPIO8: U1.38 (PC7); also elsewhere on the board
/Connections/GPIO9: U1.39 (PC8); also elsewhere on the board
/Connections/GPIO10: U1.40 (PC9); also elsewhere on the board
/Connections/GPIO11: U1.41 (PA8); also elsewhere on the board
/Connections/SWITCH_0: U1.24 (PC4); also elsewhere on the board
/Connections/SWITCH_1: U1.25 (PC5); also elsewhere on the board
/Connections/USB_D+: U1.45 (PA12); also elsewhere on the board
/Connections/USB_D-: U1.44 (PA11); also elsewhere on the board
/Processor/LED_BLUE: R47.2, U1.51 (PC10)
/Processor/LED_GREEN: R49.2, U1.53 (PC12)
/Processor/LED_RED: R48.2, U1.52 (PC11)
/Processor/MCU_CKL_IN: C60.1, U1.5 (PH0), Y1.3
/Processor/MCU_CLK_OUT: C59.1, R43.1, Y1.1
/Processor/MCU_~RST: C53.1, R38.2, U1.7 (NRST)
/Processor/SWCLK: D19.2 (A2), J12.4 (SWCLK), U1.49 (PA14)
/Processor/SWDIO: D18.2 (A2), J12.2 (SWDIO), U1.46 (PA13)
/Processor/SWO: D17.2 (A2), J12.6 (SWO), U1.55 (PB3)
/Processor/nRESET: D20.2 (A2), J12.3 (~RESET), R38.1
GND: C12.2, C51.2, C52.2, C53.2, C58.2, C59.2, C60.2, C61.2, C62.2, C63.2, C65.2, C66.2, C67.2, C75.2, C76.2, D16.1 (A1), D17.1 (A1), D18.1 (A1), D19.1 (A1), D20.1 (A1), J12.5 (GND), Q1.2 (S), Q2.2 (S), Q3.2 (S), R51.1, U1.12 (VSSA), U1.18 (VSS), U1.63 (VSS), Y1.2, Y1.4; also elsewhere on the board
unnamed: D23.1 (BA), R46.1
unnamed: D23.6 (BK), Q1.3 (D)
unnamed: D23.3 (GA), R44.1
unnamed: D23.4 (GK), Q3.3 (D)
unnamed: D23.2 (RA), R45.1
unnamed: D23.5 (RK), Q2.3 (D)
unnamed: Q1.1 (G), R47.1
unnamed: Q2.1 (G), R48.1
unnamed: Q3.1 (G), R49.1
unnamed: R51.2, U1.60 (BOOT0)
unnamed: R43.2, U1.6 (PH1)
unnamed: C51.1, U1.31 (VCAP_1)
unnamed: C52.1, U1.47 (VCAP_2)

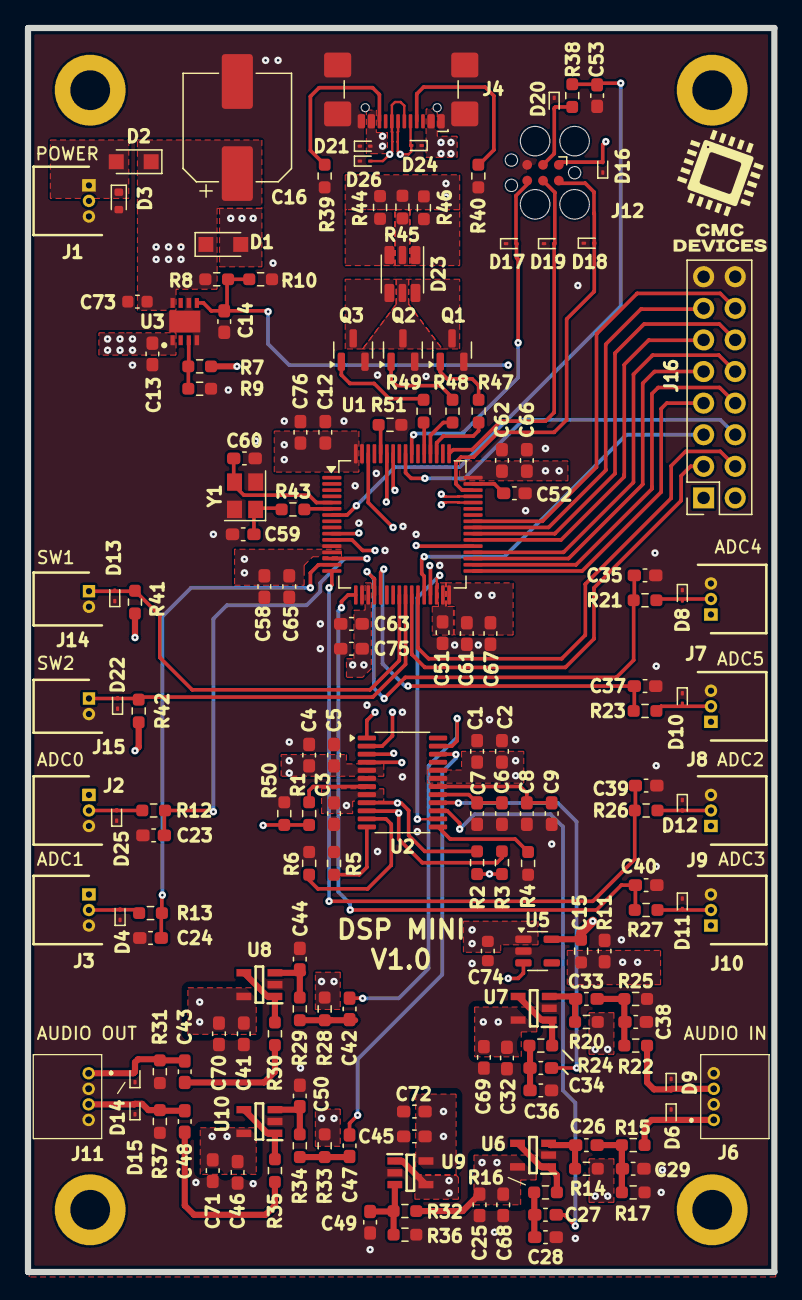
[picture p9: board Basic_DSP_V0_1.kicad_pcb from above]

Board: 6 copper layers, 60.0 x 100.0 mm, 165 parts (0 on the bottom side), 102 nets.
