CoderCallender/DSP_Projects/DSP_V0_1/DSP_V0_1.kicad_pcb

## KiCad design DSP_V0_1/DSP_V0_1.kicad_pcb (2024-06-09)

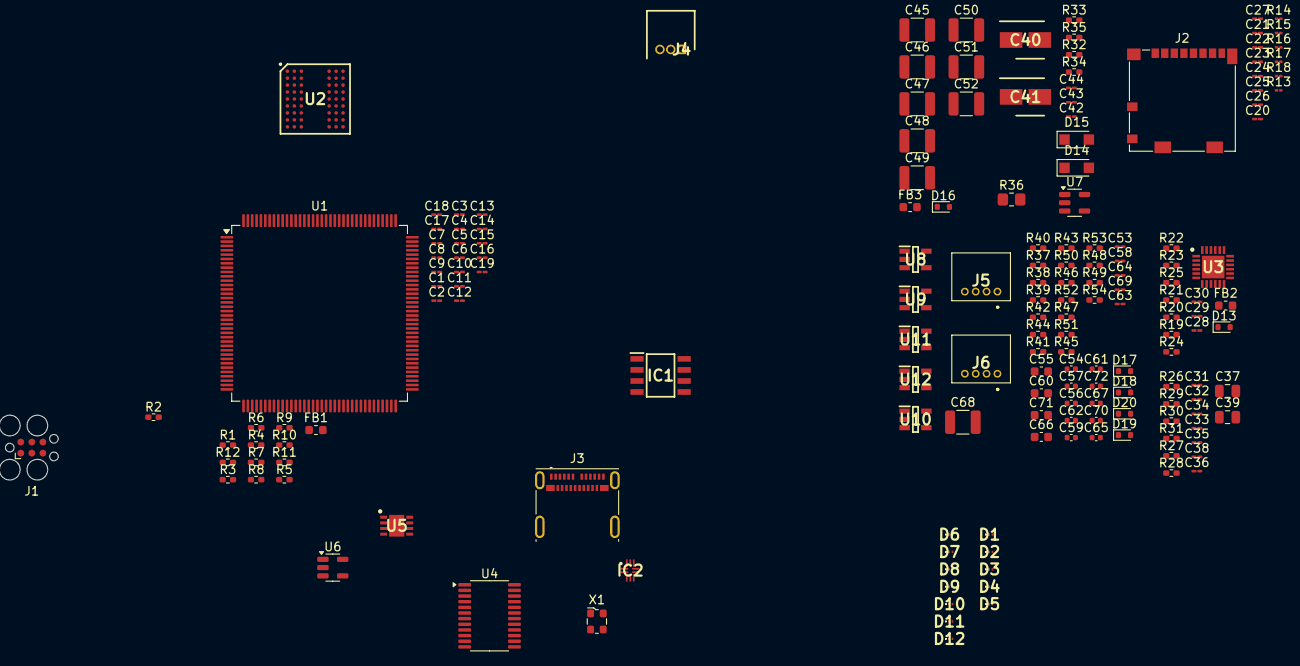
[picture p10: board DSP_V0_1.kicad_pcb from above]

Board: 2 copper layers, 170 parts (0 on the bottom side), 132 nets, no tracks yet.

Parts:
C1, C2, C3, C4, C5, C6, C7, C8, C9, C10, C11, C12, C13, C14, C15, C16, C19, C21, C22, C23, C24, C25, C26, C27, C28, C29, C31, C33, C35, C36, C38, C44, C53, C58, C63, C64, C69: 100n; C_01005_0402Metric_Pad0.57x0.30mm_HandSolder
C17, C18, C20, C30, C32, C34, C42, C43: 2u2; C_01005_0402Metric_Pad0.57x0.30mm_HandSolder
C37, C39: 10u; C_0805_2012Metric
C40, C41: 2u2; CAPAE430X550N
C45, C46, C47, C48, C49, C50, C51, C52, C68: 22u; C_1210_3225Metric
C54, C59, C65, C70: 10n; C_0402_1005Metric
C55, C60, C66, C71: 10u; C_0603_1608Metric
C56, C57, C61, C62: 220p; C_0402_1005Metric
C67, C72: 1n; C_0402_1005Metric
D1, D2, D3, D4, D5, D6, D7, D8, D9, D10, D11, D12: PESD3V3Z1BSFYL; PMEG3005AESFYL
D13, D17, D18, D19, D20: ESD5Z5.0T1G/T5G; D_SOD-523
D14, D15: PMEG4030ER; Nexperia_CFP3_SOD-123W
D16: ESD5Z12T1G/T5G; D_SOD-523
FB1, FB2, FB3: 120R; L_0603_1608Metric
IC1: IS25LP080D-JNLE-TR; SOIC127P600X175-8N
IC2: NX3DV42GU,115; QFN40P140X180X50-10N
J1: Conn_ARM_SWD_TagConnect_TC2030; Tag-Connect_TC2030-IDC-FP_2x03_P1.27mm_Vertical
J2: Micro_SD_Card_Det2; microSD_HC_Molex_104031-0811
J3: USB_C_Receptacle; USB_C_Receptacle_Molex_105450-0101
J4: 53048-0310; SHDRRA3W35P0X125_1X3_550X550X350P
J5, J6: 53048-0410; 530480410
R1, R22, R23, R24, R25: 5k1; R_0402_1005Metric_Pad0.72x0.64mm_HandSolder
R2, R32: 0R; R_0402_1005Metric_Pad0.72x0.64mm_HandSolder
R3, R4, R5, R6, R7, R8, R9, R10, R11, R12, R19, R26: 33R; R_0402_1005Metric_Pad0.72x0.64mm_HandSolder
R13, R14, R15, R16, R17, R18: 47k; R_01005_0402Metric
R20: 8k06; R_0402_1005Metric_Pad0.72x0.64mm_HandSolder
R21, R33, R34, R35, R46, R50: 47k; R_0402_1005Metric_Pad0.72x0.64mm_HandSolder
R27, R28: 2k2; R_0402_1005Metric_Pad0.72x0.64mm_HandSolder
R29, R30, R31, R49, R54: 10K; R_0402_1005Metric_Pad0.72x0.64mm_HandSolder
R36: 10R; R_0805_2012Metric_Pad1.20x1.40mm_HandSolder
R37, R40, R41, R44, R45, R51: 1M; R_0402_1005Metric_Pad0.72x0.64mm_HandSolder
R38, R42, R48, R53: 100R; R_0402_1005Metric_Pad0.72x0.64mm_HandSolder
R39, R43, R47, R52: 1K; R_0402_1005Metric_Pad0.72x0.64mm_HandSolder
U1: STM32H723ZGT6; LQFP-144_20x20mm_P0.5mm
U2: IS42S16800F-6BL; BGA54C80P9X9_800X800X120
U3: USB3318C-CP-TR; QFN50P400X400X100-25N-D
U4: CS4270; TSSOP-24_4.4x7.8mm_P0.65mm
U5: TLV76733QWDRBRQ1; SON65P300X300X100-9N-D
U6: NCP718ASN180T1G; SOT-23-5
U7: NCP718BSN500T1G; SOT-23-5
U8, U9, U10, U11, U12: TLV9161IDBVR; SOT95P280X145-5N
X1: ECS-2520MV-130-BN-TR; Oscillator_SMD_ECS_2520MV-xxx-xx-4Pin_2.5x2.0mm

Connections:
+1V8: C42.1, U3.21 (VDD1.8), U6.5 (OUT)
+3V3: C1.1, C2.1, C3.1, C4.1, C5.1, C6.1, C7.1, C10.1, C11.1, C12.1, C13.1, C14.1, C15.1, C16.1, C20.1, C21.1, C22.1, C23.1, C24.1, C25.1, C26.1, C27.1, C33.1, C34.1, C35.1, C43.1, D1.1 (K1), FB1.1, IC1.8 (VCC), IC2.9 (VCC), J1.1 (VCC), J2.4 (VDD), R2.1, R13.1, R14.1, R15.1, R16.1, R17.1, R18.1, R21.2, R27.2, R28.2, R32.1, U1.6 (VBAT), U1.17 (VDD), U1.30 (VDD), U1.39 (VDD), U1.52 (VDD), U1.62 (VDD), U1.72 (VDD), U1.84 (VDD), U1.95 (VDD33USB), U1.108 (VDD), U1.121 (VDD), U1.131 (VDD), U1.144 (VDD), U2.A7 (VDDQ_1), U2.A9 (VDD_1), U2.B3 (VDDQ_2), U2.C7 (VDDQ_3), U2.D3 (VDDQ_4), U2.E7 (VDD_2), U2.J9 (VDD_3), U3.4 (VDD3.3), U3.17 (VDDIO), U4.5 (VD), U4.8 (VLC), U5.1 (OUT), U6.1 (IN), X1.1 (Tri-State), X1.4 (VDD)
+3V3_FILT: C8.1, C9.1, FB1.2, U1.32 (VREF+), U1.33 (VDDA)
+5V: R36.1, U7.5 (OUT)
+5VA: C31.1, C32.1, C45.1, C46.1, C47.1, C48.1, C49.1, C50.1, C51.1, C52.1, C53.1, C58.1, C63.1, C64.1, C69.1, R36.2, R46.1, U4.19 (VA), U8.5 (V+), U9.5 (V+), U10.5 (V+), U11.5 (V+), U12.5 (V+)
+VREF: R37.1, R41.1, R45.1, R51.1, U11.1 (OUT), U11.4 (IN-)
/Analog/AUDIO_IN_L: D17.1 (K), J5.1, R38.1
/Analog/AUDIO_IN_R: D18.1 (K), J5.3, R42.1
/Analog/AUDIO_OUT_L: C66.2, D19.1 (K), J6.1, R49.2
/Analog/AUDIO_OUT_R: C71.2, D20.1 (K), J6.3, R54.2
/CODEC Sheet/CODEC_OUT: R26.1, U4.7 (SDOUT)
/CODEC Sheet/CODEC_~RST: U1.7 (PC13), U4.14 (~RST)
/CODEC Sheet/I2C4_SCL: R28.1, U1.81 (PD12), U4.10 (SCL/CCLK/M0)
/CODEC Sheet/I2C4_SDA: R27.1, U1.82 (PD13), U4.9 (SDA/CDOUT/M1)
/CODEC Sheet/I2S_ADC_OUT: R26.2, U1.2 (PE3)
/CODEC Sheet/I2S_BCLK: R10.1, U4.4 (SCLK)
/CODEC Sheet/I2S_DAC_IN: R11.1, U4.1 (SDIN)
/CODEC Sheet/I2S_MCLK: R8.1, U4.3 (MCLK)
/CODEC Sheet/I2S_WCLK: R9.1, U4.2 (LRCLK)
/Memory/QSPI_IO0: IC1.5 (SI(IO0)), U1.20 (PF8)
/Memory/QSPI_IO1: IC1.2 (SO(IO1)), U1.21 (PF9)
/Memory/QSPI_IO2: IC1.3 (WP#(IO2)), U1.19 (PF7)
/Memory/QSPI_IO3: IC1.7 (HOLD#_OR_RESET#_(IO3)), U1.18 (PF6)
/Memory/QSPI_SCK: IC1.6 (SCK), R7.1
/Memory/QSPI_~CE: IC1.1 (CE#), U1.91 (PG6)
/Memory/RAM_A0: U1.10 (PF0), U2.H7 (A0)
/Memory/RAM_A1: U1.11 (PF1), U2.H8 (A1)
/Memory/RAM_A2: U1.12 (PF2), U2.J8 (A2)
/Memory/RAM_A3: U1.13 (PF3), U2.J7 (A3)
/Memory/RAM_A4: U1.14 (PF4), U2.J3 (A4)
/Memory/RAM_A5: U1.15 (PF5), U2.J2 (A5)
/Memory/RAM_A6: U1.50 (PF12), U2.H3 (A6)
/Memory/RAM_A7: U1.53 (PF13), U2.H2 (A7)
/Memory/RAM_A8: U1.54 (PF14), U2.H1 (A8)
/Memory/RAM_A9: U1.55 (PF15), U2.G3 (A9)
/Memory/RAM_A10: U1.56 (PG0), U2.H9 (A10)
/Memory/RAM_A11: U1.57 (PG1), U2.G2 (A11)
/Memory/RAM_BA0: U1.89 (PG4), U2.G7 (BA0)
/Memory/RAM_BA1: U1.90 (PG5), U2.G8 (BA1)
/Memory/RAM_CKE: U1.45 (PC5), U2.F3 (CKE)
/Memory/RAM_CLK: R5.1, U2.F2 (CLK)
/Memory/RAM_D0: U1.85 (PD14), U2.A8 (DQ0)
/Memory/RAM_D1: U1.86 (PD15), U2.B9 (DQ1)
/Memory/RAM_D2: U1.114 (PD0), U2.B8 (DQ2)
/Memory/RAM_D3: U1.115 (PD1), U2.C9 (DQ3)
/Memory/RAM_D4: U1.58 (PE7), U2.C8 (DQ4)
/Memory/RAM_D5: U1.59 (PE8), U2.D9 (DQ5)
/Memory/RAM_D6: U1.60 (PE9), U2.D8 (DQ6)
/Memory/RAM_D7: U1.63 (PE10), U2.E9 (DQ7)
/Memory/RAM_D8: U1.64 (PE11), U2.E1 (DQ8)
/Memory/RAM_D9: U1.65 (PE12), U2.D2 (DQ9)
/Memory/RAM_D10: U1.66 (PE13), U2.D1 (DQ10)
/Memory/RAM_D11: U1.67 (PE14), U2.C2 (DQ11)
/Memory/RAM_D12: U1.68 (PE15), U2.C1 (DQ12)
/Memory/RAM_D13: U1.77 (PD8), U2.B2 (DQ13)
/Memory/RAM_D14: U1.78 (PD9), U2.B1 (DQ14)
/Memory/RAM_D15: U1.79 (PD10), U2.A2 (DQ15)
/Memory/RAM_DQMH: U1.142 (PE1), U2.F1 (DQMH)
/Memory/RAM_DQML: U1.141 (PE0), U2.E8 (DQML)
/Memory/RAM_NCAS: U1.132 (PG15), U2.F7 (~CAS)
/Memory/RAM_NCS: U1.44 (PC4), U2.G9 (~CS)
/Memory/RAM_NRAS: U1.49 (PF11), U2.F8 (~RAS)
/Memory/RAM_NWE: U1.43 (PA7), U2.F9 (~WE)
/Memory/SD_CLK: D11.2 (K2), J2.5 (CLK), U1.122 (PD6)
/Memory/SD_CMD: D7.2 (K2), J2.3 (CMD), R15.2, U1.123 (PD7)
/Memory/SD_D0: D8.2 (K2), J2.7 (DAT0), R16.2, U1.124 (PG9)
/Memory/SD_D1: D9.2 (K2), J2.8 (DAT1), R17.2, U1.125 (PG10)
/Memory/SD_D2: D12.2 (K2), J2.1 (DAT2), R13.2, U1.126 (PG11)
/Memory/SD_D3: D6.2 (K2), J2.2 (DAT3/CD), R14.2, U1.127 (PG12)
/Memory/SD_DET: D10.2 (K2), J2.10 (DET_A), R18.2, U1.128 (PG13)
/Power/V_ENABLE: C44.1, R33.2, R35.1, U5.5 (EN), U6.3 (EN), U7.3 (EN)
/Processor/MCU_SWCLK: R4.1, U1.109 (PA14(JTCK)
/Processor/MCU_SWDIO: R3.1, U1.105 (PA13(JTMS)
/Processor/MCU_SWO: R6.1, U1.133 (PB3(JTDO)
/Processor/MCU_~RST: C19.1, R12.2, U1.25 (NRST)
/Processor/SWCLK: D4.1 (K1), J1.4 (SWCLK), R4.2
/Processor/SWDIO: D3.1 (K1), J1.2 (SWDIO), R3.2
/Processor/SWO: D2.1 (K1), J1.6 (SWO), R6.2
/Processor/nRESET: D5.1 (K1), J1.3 (~RESET), R12.1
/USB/D+: IC2.1 (D+), J3.A6 (D+), J3.B6 (D+)
/USB/D-: IC2.2 (D-), J3.A7 (D-), J3.B7 (D-)
/USB/USB_HS_D+: IC2.5 (HSD1+), U3.6 (DP)
/USB/USB_HS_D-: IC2.4 (HSD1-), U3.5 (DM)
/USB/USB_SW: IC2.10 (S), R25.2
GND: C1.2, C2.2, C3.2, C4.2, C5.2, C6.2, C7.2, C8.2, C9.2, C10.2, C11.2, C12.2, C13.2, C14.2, C15.2, C16.2, C17.2, C18.2, C19.2, C20.2, C21.2, C22.2, C23.2, C24.2, C25.2, C26.2, C27.2, C28.2, C29.2, C30.2, C31.2, C32.2, C33.2, C34.2, C35.2, C36.2, C37.2, C38.2, C39.2, C40.2, C41.2, C42.2, C43.2, C44.2, C45.2, C46.2, C47.2, C48.2, C49.2, C50.2, C51.2, C52.2, C53.2, C56.1, C57.2, C58.2, C61.1, C62.2, C63.2, C64.2, C67.2, C68.2, C69.2, C72.2, D1.2 (K2), D2.2 (K2), D3.2 (K2), D4.2 (K2), D5.2 (K2), D6.1 (K1), D7.1 (K1), D8.1 (K1), D9.1 (K1), D10.1 (K1), D11.1 (K1), D12.1 (K1), D13.2 (A), D16.2 (A), D17.2 (A), D18.2 (A), D19.2 (A), D20.2 (A), IC1.4 (GND), IC2.8 (~OE), J1.5 (GND), J2.6 (VSS), J2.11 (SHIELD), J3.A1 (GND), J3.A12 (GND), J3.B1 (GND), J3.B12 (GND), J4.3, J5.2, J5.4, J6.2, J6.4, R1.1, R20.1, R22.1, R23.1, R25.1, R29.1, R30.1, R31.1, R34.2, R35.2, R40.2, R44.2, R49.1, R50.2, R54.1, U2.A1 (VSS_1), U2.A3 (VSSQ_1), U2.B7 (VSSQ_2), U2.C3 (VSSQ_3), U2.D7 (VSSQ_4), U2.E3 (VSS_2), U2.J1 (VSS_3), U4.6 (DGND), U4.20 (AGND), U5.4 (GND_1), U5.6 (GND_2), U5.9 (EP), U6.2 (GND), U7.2 (GND), U8.2 (V-), U9.2 (V-), U10.2 (V-), U11.2 (V-), U12.2 (V-), X1.2 (GND)
unnamed: C17.1, U1.71 (VCAP)
unnamed: C18.1, U1.106 (VCAP)
unnamed: C29.1, FB2.2
unnamed: C54.1, C57.1, R38.2, R40.1
unnamed: C55.1, C56.2, R39.2
unnamed: C59.1, C62.1, R42.2, R44.1
unnamed: C60.1, C61.2, R43.2
unnamed: C65.2, R45.2, R47.1
unnamed: C66.1, R48.2
unnamed: C70.2, R51.2, R52.1
unnamed: C71.1, R53.2
unnamed: C41.1, D14.1 (K), FB3.2, R33.1, U5.8 (IN), U7.1 (IN)
unnamed: C40.1, D15.1 (K), FB3.1
unnamed: J3.A5 (CC1), R23.2
unnamed: J3.B5 (CC2), R22.2
unnamed: R1.2, U1.138 (BOOT0)
unnamed: R2.2, U1.143 (PDR_ON)
unnamed: R8.2, U1.1 (PE2)
unnamed: R9.2, U1.3 (PE4)
unnamed: R10.2, U1.4 (PE5)
unnamed: R11.2, U1.5 (PE6)
unnamed: R7.2, U1.22 (PF10)
unnamed: R5.2, U1.93 (PG8)
unnamed: U1.16 (VSS), U1.38 (VSS), U1.51 (VSS), U1.61 (VSS), U1.83 (VSS), U1.94 (VSS), U1.107 (VSS), U1.120 (VSS), U1.130 (VSS)
unnamed: R20.2, U3.24 (RBIAS)
unnamed: R19.1, U3.23 (REFCLK)
unnamed: R21.1, U3.22 (RESETB)
unnamed: R24.1, U3.2 (VBUS)
unnamed: R31.2, U4.11 (AD0/~CS/I2S/~LJ)
unnamed: R30.2, U4.12 (AD1/CDIN/MDIV1)
unnamed: R29.2, U4.13 (AD2/MDIV2)
unnamed: C38.1, C39.1, U4.18 (FIL+)
unnamed: C36.1, C37.1, U4.17 (VQ)
unnamed: R32.2, R34.1, U5.3 (SNS)
unnamed: C54.2, R37.2, U8.3 (IN+)
unnamed: R39.1, U8.1 (OUT), U8.4 (IN-)
unnamed: C59.2, R41.2, U9.3 (IN+)
unnamed: R43.1, U9.1 (OUT), U9.4 (IN-)
unnamed: C67.1, R47.2, U10.3 (IN+)
unnamed: R48.1, U10.1 (OUT), U10.4 (IN-)
unnamed: C68.1, R46.2, R50.1, U11.3 (IN+)
unnamed: C72.1, R52.2, U12.3 (IN+)
unnamed: R53.1, U12.1 (OUT), U12.4 (IN-)
unnamed: R19.2, X1.3 (OUT)
VBUS: C28.1, D13.1 (K), FB2.1, J3.A4 (VBUS), J3.A9 (VBUS), J3.B4 (VBUS), J3.B9 (VBUS)
VBUS_FILT: C30.1, D14.2 (A), R24.2
VCC: D15.2 (A), D16.1 (K), J4.1
