CoderCallender/DSP_Projects/Firmware/FFT/DSP_mini/DSPmini/Core/Src/main.c

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
/* Includes ------------------------------------------------------------------*/
#include "main.h"

/* USER CODE BEGIN Includes */
#include "codec.h"
#include "IIR_PeakingFilter.h"
/* USER CODE END Includes */

/* USER CODE BEGIN PD */
#define NUM_ADC_CHANNELS 	6
#define AUDIO_BUFFER_SIZE	64

#define SAMPLE_RATE_HZ		46875.0f	//will change when osc is fitted to board

#define UINT16_TO_FLOAT 0.00001525878f
#define INT16_TO_FLOAT 0.00003051757f
#define FLOAT_TO_INT16 32768.0f

#define BASS_EQ_FREQ	150.0f
#define MID_EQ_FREQ		1000.0f
#define HIGH_EQ_FREQ	6000.0f
/* USER CODE END PD */

ADC_HandleTypeDef hadc1;
DMA_HandleTypeDef hdma_adc1;

I2C_HandleTypeDef hi2c1;

I2S_HandleTypeDef hi2s2;
DMA_HandleTypeDef hdma_spi2_tx;
DMA_HandleTypeDef hdma_i2s2_ext_rx;

TIM_HandleTypeDef htim2;
TIM_HandleTypeDef htim3;

/* USER CODE BEGIN PV */




uint16_t adcData[NUM_ADC_CHANNELS];	//buffer for the ADC data from the ADC used to read the potentiometers

static int16_t codecInData[AUDIO_BUFFER_SIZE];	//buffers to deal with the in/out of the codec
static int16_t codecOutData[AUDIO_BUFFER_SIZE];

volatile uint8_t audioDataReadyFlag = 0;
volatile uint8_t audio_update_lockout_flag = 0;

static volatile int16_t *codecInBuff_p;	//pointers to help handle the double buffering (read half and process the other half at the same time) of the CODEC data
static volatile int16_t *codecOutBuff_p;
//structure to hold all the ADC values from the pots
struct potentiometers
{
	uint16_t pot1;
	uint16_t pot2;
	uint16_t pot3;
	uint16_t pot4;
	uint16_t pot5;
	uint16_t pot6;
}pots;

IIR_peakingFilter bass_filter;
IIR_peakingFilter mid_filter;
IIR_peakingFilter high_filter;
/* USER CODE END PV */

void SystemClock_Config(void);
static void MX_GPIO_Init(void);
static void MX_DMA_Init(void);
static void MX_ADC1_Init(void);
static void MX_I2C1_Init(void);
static void MX_I2S2_Init(void);
static void MX_TIM2_Init(void);
static void MX_TIM3_Init(void);
/* USER CODE BEGIN PFP */
void update_filter_settings(uint16_t q_pot, uint16_t boostCut_pot, IIR_peakingFilter *filt, float centre_freq);
/* USER CODE END PFP */

/* USER CODE BEGIN 0 */

//this function is called every time an ADC conversion is complete
void HAL_ADC_ConvCpltCallback(ADC_HandleTypeDef *hadc)
{
	//HAL_GPIO_TogglePin(LED_GREEN_GPIO_Port, LED_GREEN_Pin);

	//unload the array into our structure for easier handling
	pots.pot1 = adcData[0];
	pots.pot2 = adcData[1];
	pots.pot3 = adcData[4];
	pots.pot4 = adcData[5];
	pots.pot5 = adcData[2];
	pots.pot6 = adcData[3];

	update_filter_settings(50, pots.pot2, &bass_filter, BASS_EQ_FREQ);
	update_filter_settings(500, pots.pot4, &mid_filter, MID_EQ_FREQ);
	update_filter_settings(5500, pots.pot6, &high_filter, HIGH_EQ_FREQ);
}

void update_filter_settings(uint16_t q_pot, uint16_t boostCut_pot, IIR_peakingFilter *filt, float centre_freq)
{
	//convert pot values to something in range for our filters
	//max ADC = 4096
	//205 (approx) for a 20 bit scaling
	float Q, boostCut;

	//Q = q_pot / 205;
	boostCut = (float)boostCut_pot / 2048.0;

	if(!audio_update_lockout_flag)
	{
		IIR_peakingFilter_setParams(filt, centre_freq, (float)q_pot, boostCut);
	}

}

//function is called when I2S data is half complete, so align the pointers to the first half of the buffers
void HAL_I2SEx_TxRxHalfCpltCallback(I2S_HandleTypeDef *hi2s)
{
	codecInBuff_p = &codecInData[0];
	codecOutBuff_p = &codecOutData[0];

	audioDataReadyFlag = 1;
}

//function is called when I2S data is complete, so align the pointers to the second half of the buffers
void HAL_I2SEx_TxRxCpltCallback(I2S_HandleTypeDef *hi2s)
{
	codecInBuff_p = &codecInData[AUDIO_BUFFER_SIZE/2];
	codecOutBuff_p = &codecOutData[AUDIO_BUFFER_SIZE/2];

	audioDataReadyFlag = 1;
}

void processData(void)
{
	static float leftIn, leftOut; //, rightIn, rightOut;

	audio_update_lockout_flag = 1;

	for(uint8_t n = 0; n < (AUDIO_BUFFER_SIZE/2) - 1; n += 2)
	{

	//	codecOutBuff_p[n] = codecInBuff_p[n];	//debug
		//left channel data
		leftIn = INT16_TO_FLOAT * ((float) codecInBuff_p[n]);

		if(leftIn > 1.0f)
		{
			leftIn -= 2.0f;	//make sure data is within 1/-1
		}

		//modify the data here
		leftOut = IIR_peakingFilter_update(&bass_filter, leftIn);
		leftOut = IIR_peakingFilter_update(&mid_filter, leftOut);
		leftOut = IIR_peakingFilter_update(&high_filter, leftOut);
		//leftOut = leftIn; //debug

		//convert back to signed int and transfer to DAC (via pointer)
		codecOutBuff_p[n] =  (int16_t) (FLOAT_TO_INT16 * leftOut);

		//////////////////////
		//right channel data (not used in current hardware)
	/*	rightIn = (float)codecInBuff_p[n+1];

		if(rightIn > 1.0f)
		{
			rightIn -= 2.0f;	//make sure data is within 1/-1
		}

		//modify the data here
		rightOut = rightIn;

		//convert back to signed int and transfer to DAC (via pointer)
		codecOutBuff_p[n] = (int16_t) rightOut;
*/
	}

	audio_update_lockout_flag = 0;
	audioDataReadyFlag = 0;
}

/* USER CODE END 0 */

/**
  * @brief  The application entry point.
  * @retval int
  */
int main(void)
{

  /* MCU Configuration--------------------------------------------------------*/

  /* Reset of all peripherals, Initializes the Flash interface and the Systick. */
  HAL_Init();

  /* Configure the system clock */
  SystemClock_Config();

  /* Initialize all configured peripherals */
  MX_GPIO_Init();
  MX_DMA_Init();
  MX_ADC1_Init();
  MX_I2C1_Init();
  MX_I2S2_Init();
  MX_TIM2_Init();
  MX_TIM3_Init();
  /* USER CODE BEGIN 2 */

  HAL_ADC_Start_DMA(&hadc1, (uint32_t *) adcData, NUM_ADC_CHANNELS); 	//start the ADC and link it with the DMA
  HAL_TIM_Base_Start(&htim2); 											//start timer 2 which triggers the ADC
  HAL_I2SEx_TransmitReceive_DMA(&hi2s2, (uint16_t *) codecOutData, (uint16_t *) codecInData, AUDIO_BUFFER_SIZE);
  codec_hardware_reset_pin_clear();
  HAL_Delay(50);
  codec_configure(&hi2c1);
  IIR_peakingFilter_init(&bass_filter, SAMPLE_RATE_HZ);		//initialise bass frequency peaking filter
  IIR_peakingFilter_init(&mid_filter, SAMPLE_RATE_HZ);
  IIR_peakingFilter_init(&high_filter, SAMPLE_RATE_HZ);
  /* USER CODE END 2 */

  /* Infinite loop */
  /* USER CODE BEGIN WHILE */
  while (1)
  {
	  if(audioDataReadyFlag)
	  {
		  processData();
	  }
/*	  if(HAL_GPIO_ReadPin(GPIOC, GPIO_PIN_4))		//switch 0
	  {
		  HAL_GPIO_TogglePin(GPIOC, GPIO_PIN_10);	//Blue
		  HAL_GPIO_TogglePin(GPIOC, GPIO_PIN_11);	//Red
		  HAL_Delay(500);
	  }

	  if(HAL_GPIO_ReadPin(SWITCH_1_GPIO_Port, SWITCH_1_Pin))
	  {
		  HAL_GPIO_TogglePin(LED_GREEN_GPIO_Port, LED_GREEN_Pin);
		  HAL_Delay(500);
	  }
*/
    /* USER CODE END WHILE */

    /* USER CODE BEGIN 3 */
  }
  /* USER CODE END 3 */
}

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
