CoderCallender/DSP_Projects/Firmware/FFT/DSP_mini/DSPmini/DSPmini.ioc

Mcu.UserName=STM32F415RGTx
PA0-WKUP.Signal=ADCx_IN0
PA1.Signal=ADCx_IN1
PA13.Signal=SYS_JTMS-SWDIO
PA14.Signal=SYS_JTCK-SWCLK
PA2.Signal=ADCx_IN2
PA3.Signal=ADCx_IN3
PA4.Signal=ADCx_IN4
PA5.Signal=ADCx_IN5
PB10.Signal=I2S2_CK
PB11.GPIO_Label=CODEC_RST
PB11.Signal=GPIO_Output
PB6.Signal=I2C1_SCL
PB7.Signal=I2C1_SDA
PB9.Signal=I2S2_WS
PC10.GPIO_Label=LED_BLUE
PC10.Signal=GPIO_Output
PC11.GPIO_Label=LED_RED
PC11.Signal=GPIO_Output
PC12.GPIO_Label=LED_GREEN
PC12.Signal=GPIO_Output
PC2.Signal=I2S2_ext_SD
PC3.Signal=I2S2_SD
PC4.GPIO_Label=SWITCH_0
PC4.Signal=GPIO_Input
PC5.GPIO_Label=SWITCH_1
PC5.Signal=GPIO_Input
PC6.Signal=I2S2_MCK
