CoderCallender/DSP_Projects/Firmware/FFT/DSP_mini/DSPmini/Core/Inc/main.h

#define SWITCH_0_Pin GPIO_PIN_4
#define SWITCH_0_GPIO_Port GPIOC
#define SWITCH_1_Pin GPIO_PIN_5
#define SWITCH_1_GPIO_Port GPIOC
#define CODEC_RST_Pin GPIO_PIN_11
#define CODEC_RST_GPIO_Port GPIOB
#define LED_BLUE_Pin GPIO_PIN_10
#define LED_BLUE_GPIO_Port GPIOC
#define LED_RED_Pin GPIO_PIN_11
#define LED_RED_GPIO_Port GPIOC
#define LED_GREEN_Pin GPIO_PIN_12
#define LED_GREEN_GPIO_Port GPIOC
