CoderCallender/DSP_Projects/(commit log)

2024-06-09 Initial commit of the Basic DSP project
    [Analogue.kicad_sch, Basic_DSP_V0_1.kicad_pcb, Basic_DSP_V0_1.kicad_sch, CODEC.kicad_sch, Power.kicad_sch, Processor.kicad_sch]
2024-06-10 Updates to basic DSP schematic
    [Analogue.kicad_sch, Basic_DSP_V0_1.kicad_sch, CODEC.kicad_sch, Connections.kicad_sch, Power.kicad_sch, Processor.kicad_sch]
2024-06-11 Minor updates to Basic schematic
    [Analogue.kicad_sch, CODEC.kicad_sch, Connections.kicad_sch, Power.kicad_sch, Processor.kicad_sch]
2024-06-13 Started layout
    Removed library from repo as it was messin with the links
    [Analogue.kicad_sch, Basic_DSP_V0_1.kicad_pcb, Basic_DSP_V0_1.kicad_sch, CODEC.kicad_sch, Connections.kicad_sch, Power.kicad_sch, Processor.kicad_sch]
2024-06-14 Basic placement on PCB
    [Basic_DSP_V0_1.kicad_pcb, Power.kicad_sch, Processor.kicad_sch]
2024-06-19 Updated parts with LCSC order codes
    [Analogue.kicad_sch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]
2024-07-17 WIP - small layout progress on basic DSP
    [Basic_DSP_V0_1.kicad_pcb, Connections.kicad_sch, Processor.kicad_sch]
2024-07-18 more layout work on basic DSP
    [Analogue.kicad_sch, Basic_DSP_V0_1.kicad_pcb]
2024-08-25 Cleaned up the designators on Basic DSP layout
    [Basic_DSP_V0_1.kicad_pcb]
2024-08-29 More layout on Basic_DSP_V0_1 and a change of USB connector
    [Basic_DSP_V0_1.kicad_pcb, Connections.kicad_sch]
2024-09-03 More layout work
    [Basic_DSP_V0_1.kicad_pcb, Connections.kicad_sch]
2024-09-04 More layout updates
    [Basic_DSP_V0_1.kicad_pcb]
2024-09-05 Minor layout work
    [Basic_DSP_V0_1.kicad_pcb, Processor.kicad_sch]
2024-09-06 Layout and removal of PDN ferrites
    [Basic_DSP_V0_1.kicad_pcb, CODEC.kicad_sch, Connections.kicad_sch, Power.kicad_sch, Processor.kicad_sch]
2024-09-08 All nets connected - DRC issues to be resolved
    [Basic_DSP_V0_1.kicad_pcb]
2024-09-09 No errors from DRC on layout
    [Basic_DSP_V0_1.kicad_pcb, Basic_DSP_V0_1.kicad_sch, Connections.kicad_sch]
2024-09-12 Tidy layout ready for review
    [Basic_DSP_V0_1-BOTTOM_SIG_Cu.gbr, Basic_DSP_V0_1-B_Mask.gbr, Basic_DSP_V0_1-B_Paste.gbr, Basic_DSP_V0_1-B_Silkscreen.gbr, Basic_DSP_V0_1-Edge_Cuts.gbr, Basic_DSP_V0_1-F_Mask.gbr, Basic_DSP_V0_1-F_Paste.gbr, Basic_DSP_V0_1-F_Silkscreen.gbr]
2024-11-25 Basic firmware to test hardware
    [Basic_DSP_V0_1-BOTTOM_SIG_Cu.gbr, Basic_DSP_V0_1-B_Mask.gbr, Basic_DSP_V0_1-B_Paste.gbr, Basic_DSP_V0_1-B_Silkscreen.gbr, Basic_DSP_V0_1-Edge_Cuts.gbr, Basic_DSP_V0_1-F_Mask.gbr, Basic_DSP_V0_1-F_Paste.gbr, Basic_DSP_V0_1-F_Silkscreen.gbr]
2024-12-07 Working example of 2 peaking filters. Not perfect. Needs re-calculating (maybe) as it fails over 500Hz or so. Also not sure if it is cutting correctly...
    [IIR_PeakingFilter.c, IIR_PeakingFilter.h, main.c]
