CoderCallender/DSP_Projects/(notices)

Notices in the files:
Firmware/FFT/DSP_mini/DSPmini/Core/Inc/main.h:
Copyright (c) 2024 STMicroelectronics.
All rights reserved.
This software is licensed under terms that can be found in the LICENSE file
